phellberg76/Perfect-Vision-ECU/jlcpcb/production_files/BOM-Perfect-Vision-ECU.csv

Comment | Designator | Footprint | LCSC | Quantity
100R | R1 | R_0402_1005Metric | C25076 | 1
100k | R3 | R_0402_1005Metric | C25741 | 1
100nF | C1,C12,C2,C5,C6,C9 | C_0402_1005Metric | C1525 | 6
100uF 25v | C3 | CP_Elec_6.3x7.7 | C72477 | 1
100uH | L1 | L_12x12mm_H4.5mm | C504036 | 1
10R | R24 | R_0402_1005Metric | C25077 | 1
10k | R14,R15,R23 | R_0402_1005Metric | C25744 | 3
10k | R18,R19,R6 | R_0402_1005Metric | C2906861 | 3
10uF | C11 | C_0805_2012Metric | C15850 | 1
120R | R2 | R_0402_1005Metric | C25079 | 1
1N4148W | D10 | D_SOD-123 | C81598 | 1
1k | R5,R7,R8,R9 | R_0402_1005Metric | C11702 | 4
1uF | C17 | C_0402_1005Metric | C52923 | 1
200R | R20 | R_0603_1608Metric | C8218 | 1
220uF 25v | C4 | CP_Elec_8x10.5 | C3353 | 1
22pF | C7,C8 | C_0402_1005Metric | C1555 | 2
470k | R4 | R_0402_1005Metric | C25790 | 1
47nH | L2 | L_0402_1005Metric | C27151 | 1
5k1 | R34,R35 | R_0402_1005Metric | C22356228 | 2
8MHz | Y2 | Crystal_SMD_3225-4Pin_3.2x2.5mm | C2682774 | 1
BAT54J | D12 | D_SOD-323F | C358488 | 1
Conn_Coaxial | J6 | U.FL_Hirose_U.FL-R-SMT-1_Vertical | C88374 | 1
D_Schottky | D8 | D_SMC | C13763 | 1
D_Schottky | D1 | D_SMC | C18199210 | 1
D_TVS_Dual_ACA | D2,D3 | SOT-23 | C284078 | 2
ESP32-S3-MINI-1 | U2 | ESP32-S2-MINI-1 | C2913206 | 1
G6K-2 12V | K1 | Relay_DPDT_Omron_G6K-2F-Y | C397194 | 1
LED | D11,D7 | LED_0603_1608Metric | C2286 | 2
LM2596S-3.3 | U3 | TO-263-5_TabPin3 | C347420 | 1
MCP2515-xSO | U6 | SOIC-18W_7.5x11.6mm_P1.27mm | C153782 | 1
NEO-M9N-00B | U1 | SMT_9N-00B_UBL | C5119087 | 1
PRTR5V0U2X | D4 | SOT-143 | C5158049 | 1
PTVS18VZ1USK | D9 | D_SMA | C134965 | 1
PZT2222A | Q1 | SOT-223-3_TabPin2 | C115272 | 1
SN65HVD230 | U7,U8 | SOIC-8_3.9x4.9mm_P1.27mm | C12084 | 2
SS34 | D6 | D_SMA | C8678 | 1
USB_C_Receptacle_USB2.0_16P | J5 | USB_C_Receptacle_HRO_TYPE-C-31-M-12 | C165948 | 1
