phellberg76/Perfect-Vision-ECU/Perfect-Vision-ECU.kicad_pcb

## KiCad design Perfect-Vision-ECU.kicad_pcb (2026-10-21)

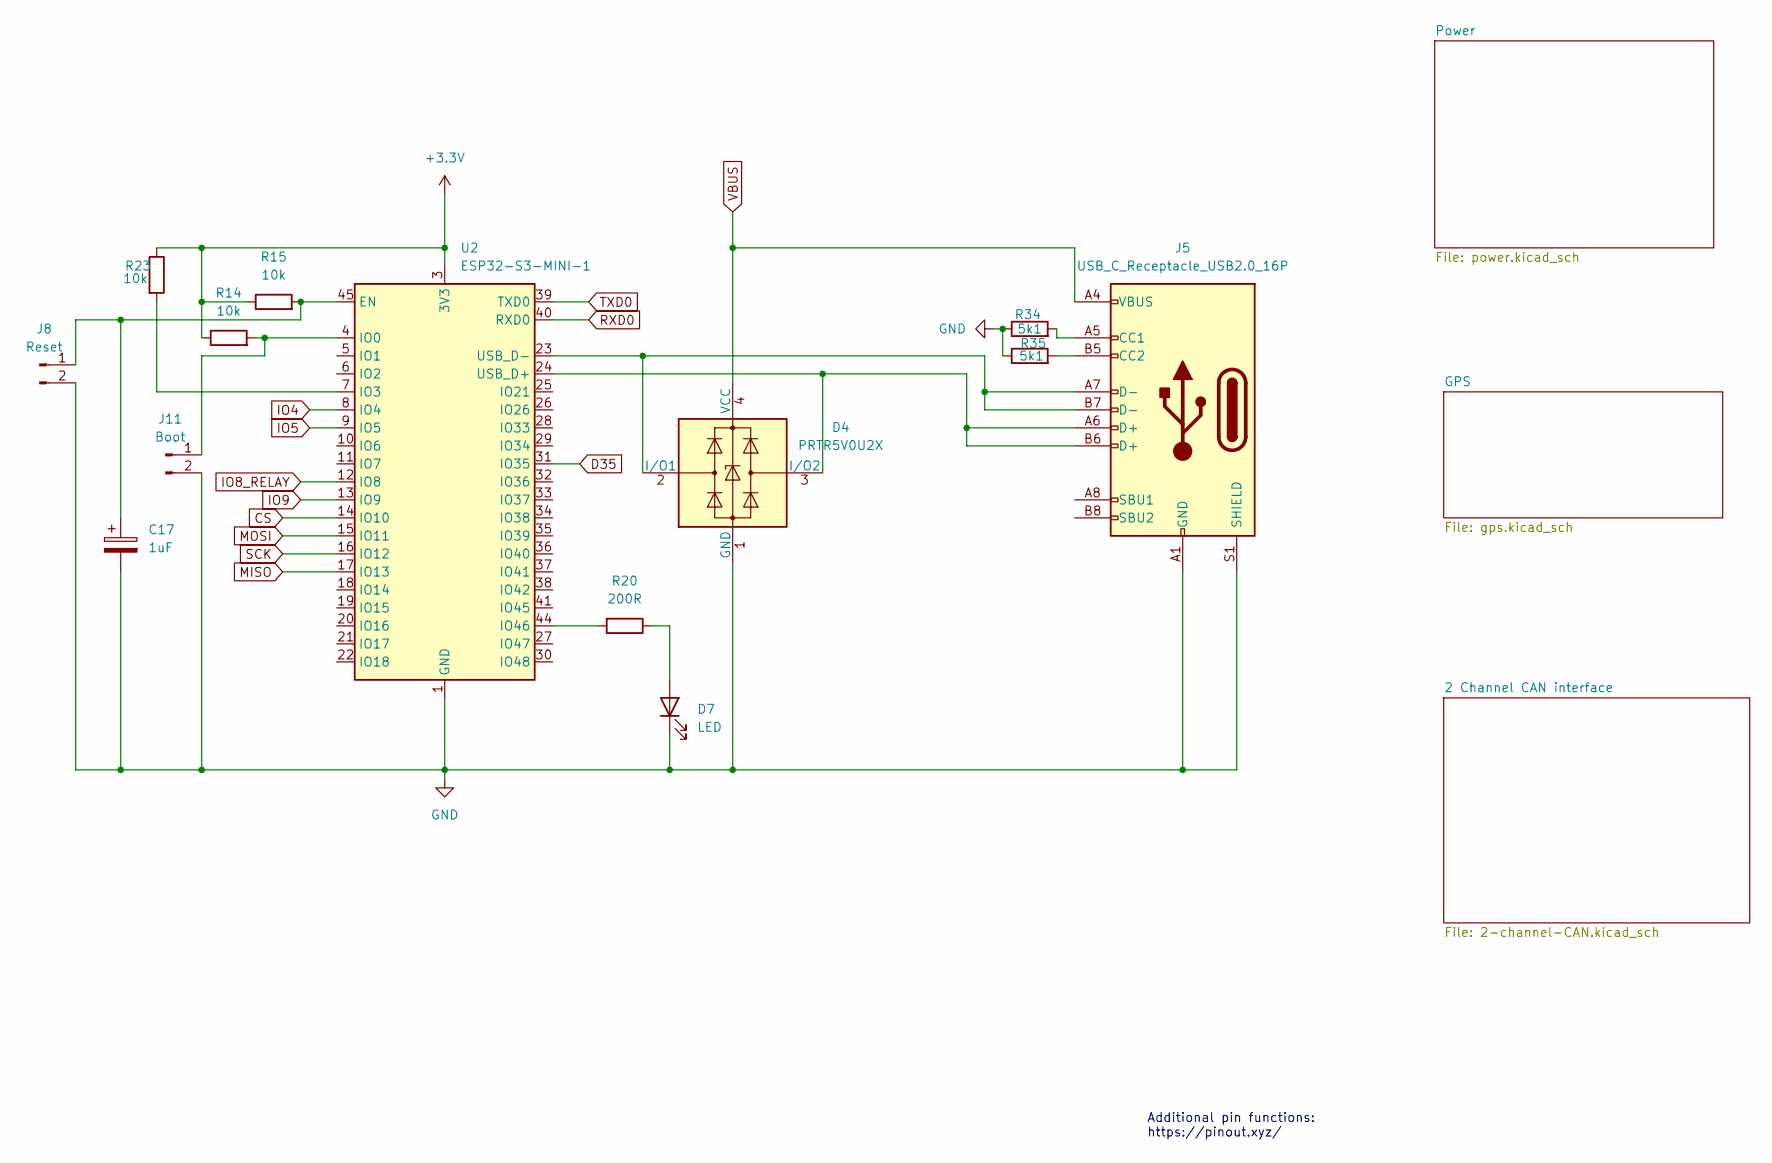
[picture p1: schematic Perfect-Vision-ECU.kicad_sch]

Parts:
C17: 1uF; C_0402_1005Metric
D4: PRTR5V0U2X; SOT-143
D7: LED; LED_0603_1608Metric
J5: USB_C_Receptacle_USB2.0_16P; USB_C_Receptacle_HRO_TYPE-C-31-M-12
J8: Reset; PinHeader_1x02_P2.54mm_Vertical
J11: Boot; PinHeader_1x02_P2.54mm_Vertical
R14, R15, R23: 10k; R_0402_1005Metric
R20: 200R; R_0603_1608Metric
R34, R35: 5k1; R_0402_1005Metric
U2: ESP32-S3-MINI-1; ESP32-S2-MINI-1

Connections:
+3.3V: R14.1, R15.1, R23.1, U2.3 (3V3); also elsewhere on the board
CS: U2.14 (IO10); also elsewhere on the board
D35: U2.31 (IO35); also elsewhere on the board
GND: C17.2, D4.1 (GND), D7.1 (K), J5.A1 (GND), J5.A12 (GND), J5.B1 (GND), J5.B12 (GND), J5.S1 (SHIELD), J8.2, J11.2, R34.1, R35.1, U2.1 (GND), U2.2 (GND), U2.42 (GND), U2.43 (GND), U2.46 (GND), U2.47 (GND), U2.48 (GND), U2.49 (GND), U2.50 (GND), U2.51 (GND), U2.52 (GND), U2.53 (GND), U2.54 (GND), U2.55 (GND), U2.56 (GND), U2.57 (GND), U2.58 (GND), U2.59 (GND), U2.60 (GND), U2.61 (GND), U2.62 (GND), U2.63 (GND), U2.64 (GND), U2.65 (GND); also elsewhere on the board
IO4: U2.8 (IO4); also elsewhere on the board
IO5: U2.9 (IO5); also elsewhere on the board
IO8_RELAY: U2.12 (IO8); also elsewhere on the board
IO9: U2.13 (IO9); also elsewhere on the board
MISO: U2.17 (IO13); also elsewhere on the board
MOSI: U2.15 (IO11); also elsewhere on the board
unnamed: D4.2 (I/O1), J5.A7 (D-), J5.B7 (D-), U2.23 (USB_D-)
unnamed: D4.3 (I/O2), J5.A6 (D+), J5.B6 (D+), U2.24 (USB_D+)
unnamed: D7.2 (A), R20.1
unnamed: J5.A5 (CC1), R34.2
unnamed: J5.B5 (CC2), R35.2
unnamed: C17.1, J8.1, R15.2, U2.45 (EN)
unnamed: J11.1, R14.2, U2.4 (IO0)
unnamed: R23.2, U2.7 (IO3)
unnamed: R20.2, U2.44 (IO46)
RXD0: U2.40 (RXD0); also elsewhere on the board
SCK: U2.16 (IO12); also elsewhere on the board
TXD0: U2.39 (TXD0); also elsewhere on the board
VBUS: D4.4 (VCC), J5.A4 (VBUS), J5.A9 (VBUS), J5.B4 (VBUS), J5.B9 (VBUS); also elsewhere on the board

Notes on the sheet:
Additional pin functions: https://pinout.xyz/

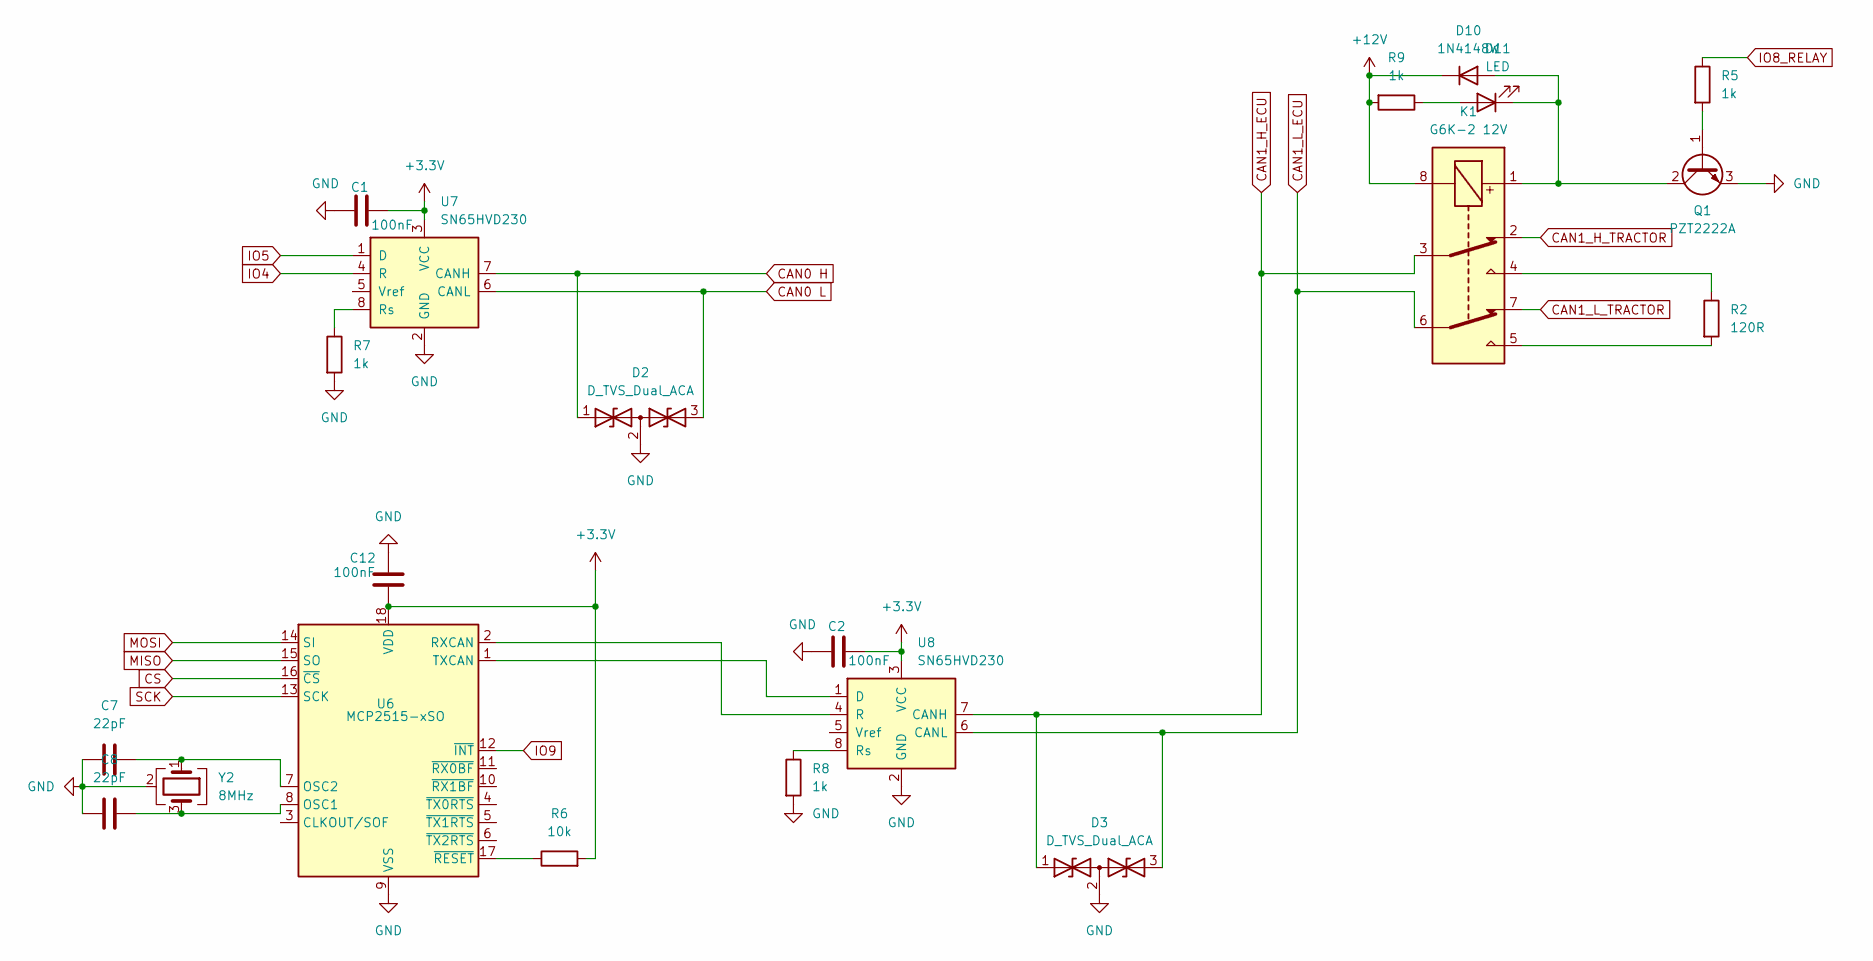
[picture p2: schematic 2-channel-CAN.kicad_sch]

Parts:
C1, C2, C12: 100nF; C_0402_1005Metric
C7, C8: 22pF; C_0402_1005Metric
D2, D3: D_TVS_Dual_ACA; SOT-23
D10: 1N4148W; D_SOD-123
D11: LED; LED_0603_1608Metric
K1: G6K-2 12V; Relay_DPDT_Omron_G6K-2F-Y
Q1: PZT2222A; SOT-223-3_TabPin2
R2: 120R; R_0402_1005Metric
R5, R7, R8, R9: 1k; R_0402_1005Metric
R6: 10k; R_0402_1005Metric
U6: MCP2515-xSO; SOIC-18W_7.5x11.6mm_P1.27mm
U7, U8: SN65HVD230; SOIC-8_3.9x4.9mm_P1.27mm
Y2: 8MHz; Crystal_SMD_3225-4Pin_3.2x2.5mm

Connections:
+3.3V: C1.1, C2.1, C12.2, R6.2, U6.18 (VDD), U7.3 (VCC), U8.3 (VCC); also elsewhere on the board
+12V: D10.1 (K), K1.8, R9.2; also elsewhere on the board
CAN0 H: D2.1 (A1), U7.7 (CANH); also elsewhere on the board
CAN0 L: D2.3 (A2), U7.6 (CANL); also elsewhere on the board
CAN1_H_ECU: D3.1 (A1), K1.3, U8.7 (CANH); also elsewhere on the board
CAN1_H_TRACTOR: K1.2; also elsewhere on the board
CAN1_L_ECU: D3.3 (A2), K1.6, U8.6 (CANL); also elsewhere on the board
CAN1_L_TRACTOR: K1.7; also elsewhere on the board
CS: U6.16 (~CS); also elsewhere on the board
GND: C1.2, C2.2, C7.1, C8.1, C12.1, D2.2 (common), D3.2 (common), Q1.3 (E), R7.2, R8.2, U6.9 (VSS), U7.2 (GND), U8.2 (GND), Y2.2 (G), Y2.4 (G); also elsewhere on the board
IO4: U7.4 (R); also elsewhere on the board
IO5: U7.1 (D); also elsewhere on the board
IO8_RELAY: R5.1; also elsewhere on the board
IO9: U6.12 (~INT); also elsewhere on the board
MISO: U6.15 (SO); also elsewhere on the board
MOSI: U6.14 (SI); also elsewhere on the board
unnamed: D10.2 (A), D11.1 (K), K1.1, Q1.2 (C)
unnamed: D11.2 (A), R9.1
unnamed: K1.4, R2.1
unnamed: K1.5, R2.2
unnamed: Q1.1 (B), R5.2
unnamed: C8.2, U6.8 (OSC1), Y2.3
unnamed: C7.2, U6.7 (OSC2), Y2.1
unnamed: U6.2 (RXCAN), U8.4 (R)
unnamed: U6.1 (TXCAN), U8.1 (D)
unnamed: R6.1, U6.17 (~RESET)
unnamed: R7.1, U7.8 (Rs)
unnamed: R8.1, U8.8 (Rs)
SCK: U6.13 (SCK); also elsewhere on the board

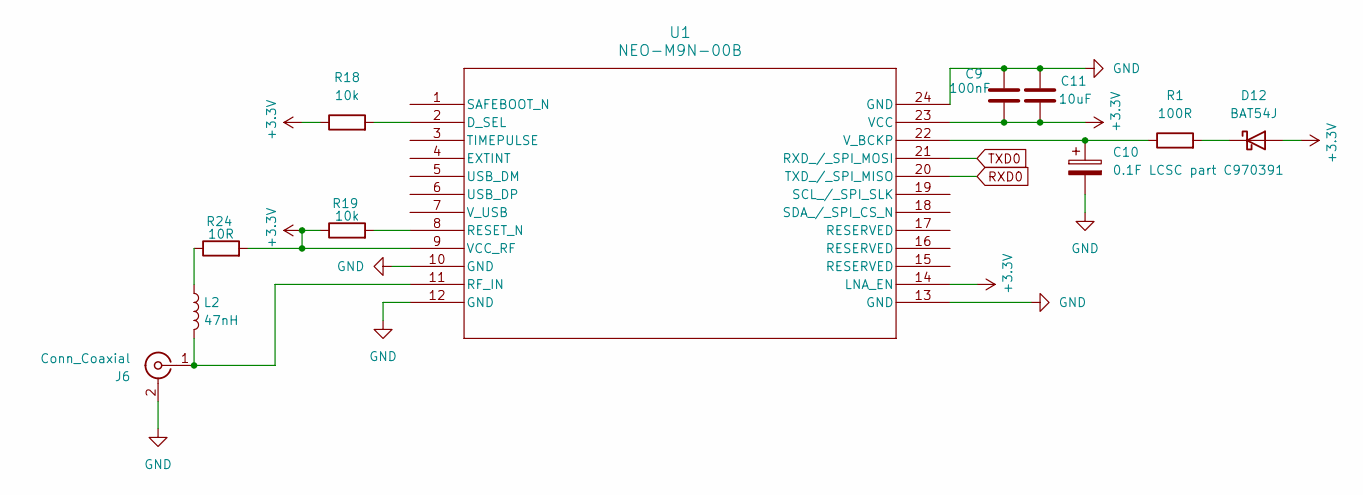
[picture p3: schematic gps.kicad_sch]

Parts:
C9: 100nF; C_0402_1005Metric
C10: 0.1F LCSC part C970391; CP_Radial_D8.0mm_P3.50mm
C11: 10uF; C_0805_2012Metric
D12: BAT54J; D_SOD-323F
J6: Conn_Coaxial; U.FL_Hirose_U.FL-R-SMT-1_Vertical
L2: 47nH; L_0402_1005Metric
R1: 100R; R_0402_1005Metric
R18, R19: 10k; R_0402_1005Metric
R24: 10R; R_0402_1005Metric
U1: NEO-M9N-00B; SMT_9N-00B_UBL

Connections:
+3.3V: C9.2, C11.2, D12.2 (A), R18.1, R19.1, R24.2, U1.9 (VCC_RF), U1.14 (LNA_EN), U1.23 (VCC); also elsewhere on the board
GND: C9.1, C10.2, C11.1, J6.2 (Ext), U1.10 (GND), U1.12 (GND), U1.13 (GND), U1.24 (GND); also elsewhere on the board
unnamed: D12.1 (K), R1.2
unnamed: J6.1 (In), L2.2, U1.11 (RF_IN)
unnamed: L2.1, R24.1
unnamed: R18.2, U1.2 (D_SEL)
unnamed: R19.2, U1.8 (RESET_N)
unnamed: C10.1, R1.1, U1.22 (V_BCKP)
RXD0: U1.20 (TXD_/_SPI_MISO); also elsewhere on the board
TXD0: U1.21 (RXD_/_SPI_MOSI); also elsewhere on the board

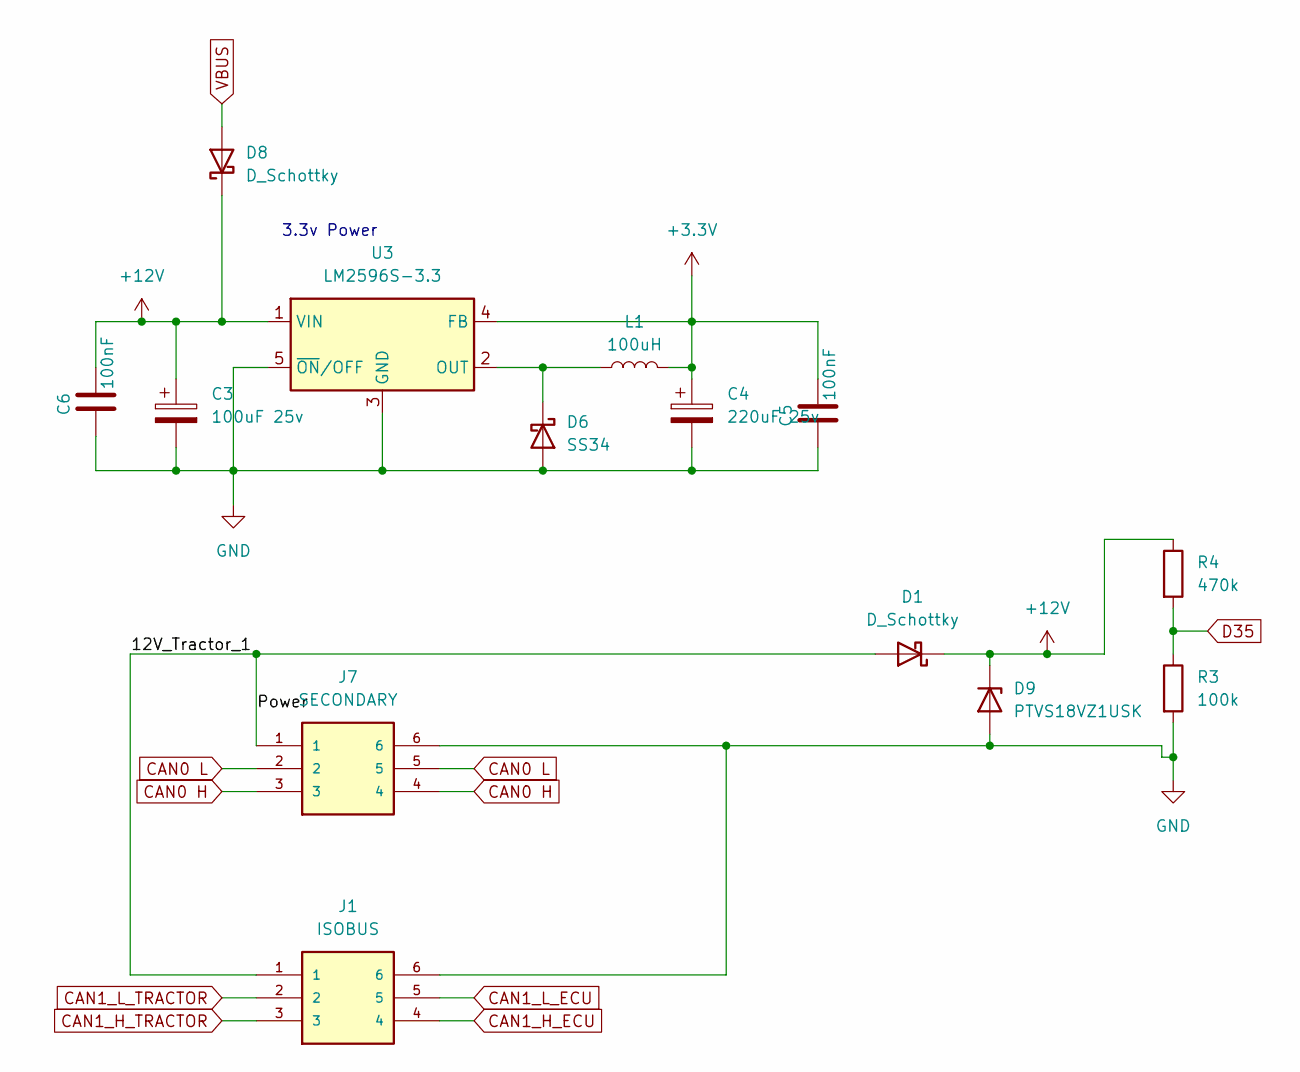
[picture p4: schematic power.kicad_sch]

Parts:
C3: 100uF 25v; CP_Elec_6.3x7.7
C4: 220uF 25v; CP_Elec_8x10.5
C5, C6: 100nF; C_0402_1005Metric
D1, D8: D_Schottky; D_SMC
D6: SS34; D_SMA
D9: PTVS18VZ1USK; D_SMA
J1: ISOBUS; AT04-6P-BM; PARTREV C1
J7: SECONDARY; AT04-6P-BM; PARTREV C1
L1: 100uH; L_12x12mm_H4.5mm
R3: 100k; R_0402_1005Metric
R4: 470k; R_0402_1005Metric
U3: LM2596S-3.3; TO-263-5_TabPin3

Connections:
+3.3V: C4.1, C5.1, L1.2, U3.4 (FB); also elsewhere on the board
+12V: C3.1, C6.1, D1.1 (K), D8.1 (K), D9.1 (K), R4.1, U3.1 (VIN); also elsewhere on the board
/Power/12V_Tractor_1: D1.2 (A), J1.1, J7.1
CAN0 H: J7.3, J7.4; also elsewhere on the board
CAN0 L: J7.2, J7.5; also elsewhere on the board
CAN1_H_ECU: J1.4; also elsewhere on the board
CAN1_H_TRACTOR: J1.3; also elsewhere on the board
CAN1_L_ECU: J1.5; also elsewhere on the board
CAN1_L_TRACTOR: J1.2; also elsewhere on the board
D35: R3.1, R4.2; also elsewhere on the board
GND: C3.2, C4.2, C5.2, C6.2, D6.2 (A), D9.2 (A), J1.6, J7.6, R3.2, U3.3 (GND), U3.5 (~ON/OFF); also elsewhere on the board
unnamed: D6.1 (K), L1.1, U3.2 (OUT)
VBUS: D8.2 (A); also elsewhere on the board

Notes on the sheet:
3.3v Power

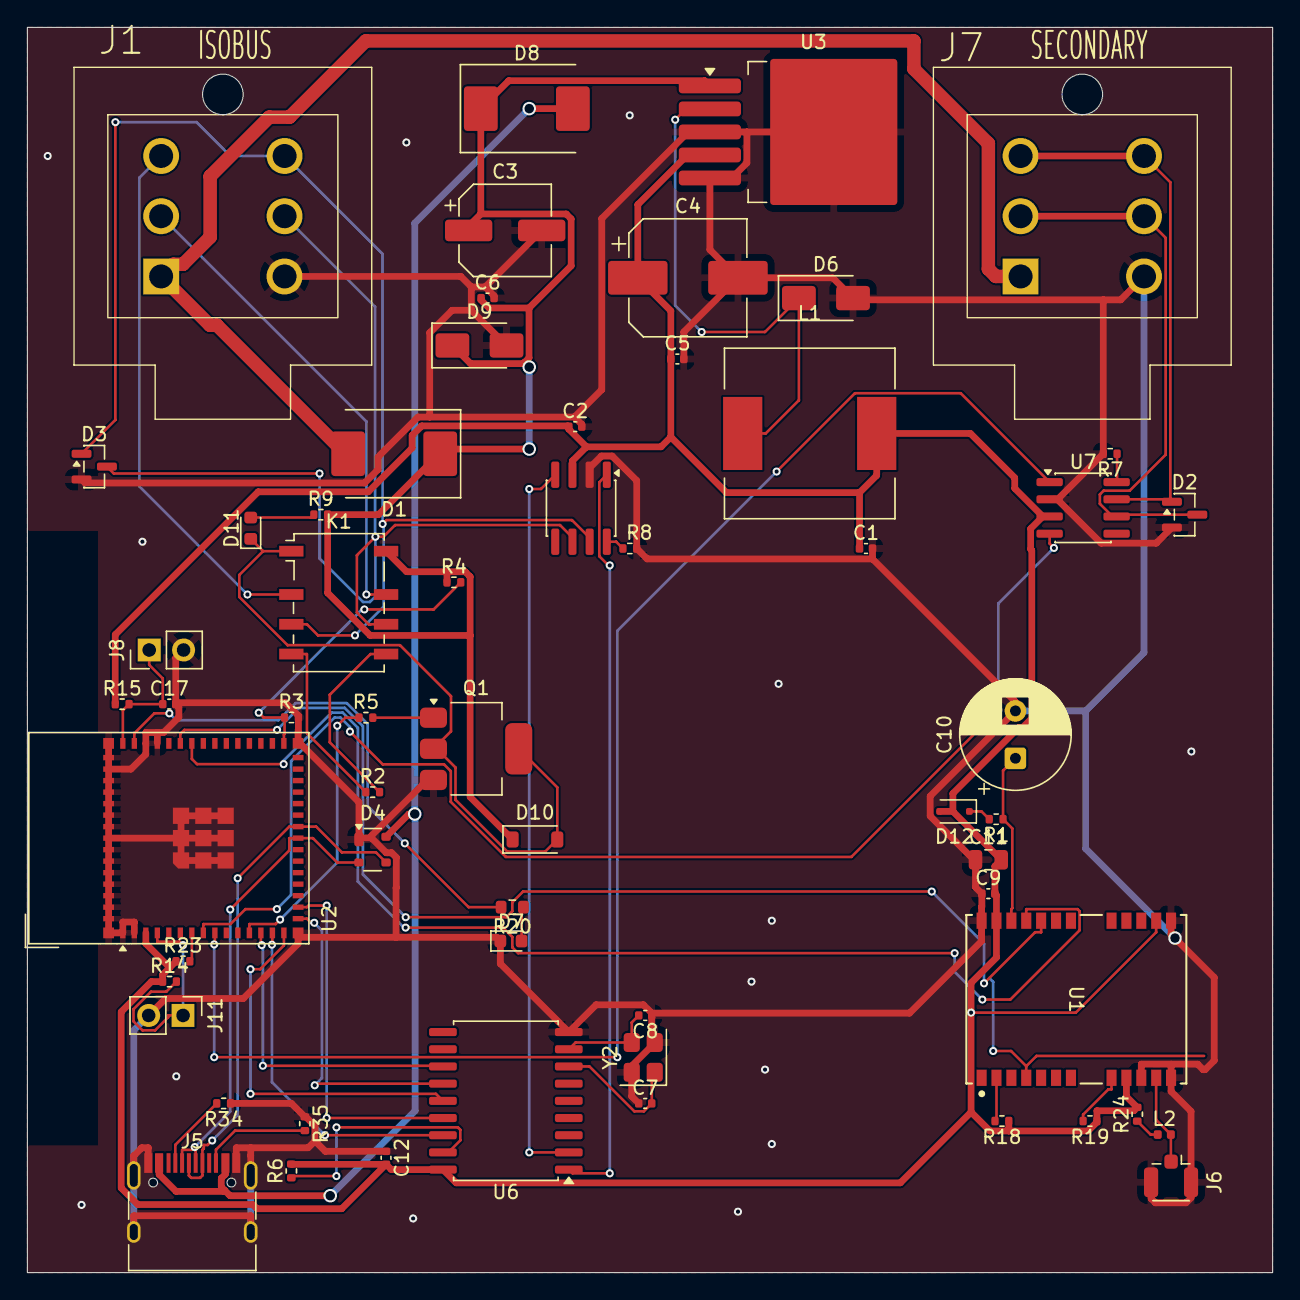
[picture p5: board Perfect-Vision-ECU.kicad_pcb from above]

Board: 2 copper layers, 92.0 x 92.0 mm, 59 parts (0 on the bottom side), 50 nets.
