phellberg76/Perfect-Vision-ECU/firmware/main/main.c

/**
 * @file main.c
 * @brief Perfect Vision ECU - CAN/BLE Bridge Main Application
 *
 * This firmware provides a CAN-to-BLE bridge functionality for the
 * Perfect Vision ECU. It reads CAN messages from two channels:
 * - CAN0: ESP32-S3 internal TWAI controller
 * - CAN1: MCP2515 external SPI CAN controller
 *
 * Messages are buffered and streamed via BLE (Nordic UART Service) to
 * a connected Flutter app. OTA firmware updates are supported via WiFi,
 * triggered by BLE commands from the app.
 *
 * GPS Integration Status
 * ----------------------
 * Basic GPS reading and NMEA parsing is implemented (gps.c):
 * - UART reading from GPS module (TXD0/RXD0 - see gps.kicad_sch)
 * - GGA parsing for position, fix quality, satellites
 * - RMC parsing for speed and course
 * - Raw NMEA logging enabled for testing
 *
 * TODO: Remaining GPS tasks:
 * - Add GPS data to BLE stream alongside CAN messages
 * - Add BLE command to enable/disable GPS streaming
 * - Use GPS as fallback when ISOBUS position data is unavailable
 */

#include <stdio.h>
#include <string.h>

#include "freertos/FreeRTOS.h"
#include "freertos/task.h"
#include "esp_system.h"
#include "esp_log.h"
#include "esp_ota_ops.h"
#include "nvs_flash.h"
#include "cJSON.h"

#include "driver/gpio.h"
#include "driver/uart.h"

#include "config.h"
#include "pin_config.h"
#include "can_manager.h"
#include "can_buffer.h"
#include "ble_nus.h"
#include "wifi_ota.h"
#include "gps.h"
#include "status_led.h"
#include "web_log.h"
#include "wifi_transfer.h"

static const char *TAG = "main";

// Cached firmware hash (SHA256)
static char s_firmware_hash[65] = {0};

// Current request ID (for including in responses)
static int s_current_request_id = -1;

// WiFi scan request ID (saved because scan is async)
static int s_wifi_scan_request_id = -1;

// Binary CAN TX mode
static bool s_can_tx_binary_mode = false;
static uint32_t s_can_tx_frame_count = 0;

// Forward declarations
static void on_ble_receive(const char *data, size_t len);
static void on_ble_binary_receive(const uint8_t *data, size_t len);
static void on_ble_connection_change(bool connected);
static void on_wifi_ota_progress(wifi_ota_status_t status, int progress,
                                  size_t received, size_t total, const char *message);
static void on_wifi_scan_result(const wifi_scan_result_t *results, size_t count,
                                 const char *error_msg);
static void on_wifi_transfer_state_change(wifi_transfer_state_t state);
static void on_wifi_transfer_receive(const uint8_t *data, size_t len);

// -----------------------------------------------------------------------------
// Response Helpers
// -----------------------------------------------------------------------------

static void send_json_response(cJSON *json)
{
    // Include request ID in response if available
    if (s_current_request_id >= 0) {
        cJSON_AddNumberToObject(json, "id", s_current_request_id);
    }

    char *str = cJSON_PrintUnformatted(json);
    if (str) {
        ble_nus_send(str, 0);
        free(str);
    }
    cJSON_Delete(json);
}

static void send_error(int code, const char *message)
{
    cJSON *json = cJSON_CreateObject();
    cJSON_AddStringToObject(json, "type", "error");
    cJSON_AddNumberToObject(json, "code", code);
    cJSON_AddStringToObject(json, "message", message);
    send_json_response(json);
}

static void send_ok(const char *message)
{
    cJSON *json = cJSON_CreateObject();
    cJSON_AddStringToObject(json, "type", "ok");
    if (message) {
        cJSON_AddStringToObject(json, "message", message);
    }
    send_json_response(json);
}

static void send_debug(const char *message)
{
    cJSON *json = cJSON_CreateObject();
    cJSON_AddStringToObject(json, "type", "debug");
    cJSON_AddStringToObject(json, "message", message);
    send_json_response(json);
}

// -----------------------------------------------------------------------------
// Firmware Hash
// -----------------------------------------------------------------------------

static const char* get_firmware_hash(void)
{
    if (s_firmware_hash[0] != '\0') {
        return s_firmware_hash;
    }

    const esp_partition_t *running = esp_ota_get_running_partition();
    if (running == NULL) {
        return "unknown";
    }

    esp_app_desc_t app_desc;
    if (esp_ota_get_partition_description(running, &app_desc) != ESP_OK) {
        return "unknown";
    }

    // Convert SHA256 to hex string
    for (int i = 0; i < 32; i++) {
        snprintf(&s_firmware_hash[i * 2], 3, "%02x", app_desc.app_elf_sha256[i]);
    }
    s_firmware_hash[64] = '\0';

    return s_firmware_hash;
}

// -----------------------------------------------------------------------------
// BLE Command Handlers
// -----------------------------------------------------------------------------

static void handle_version_cmd(void)
{
    cJSON *json = cJSON_CreateObject();
    cJSON_AddStringToObject(json, "type", "version");
    cJSON_AddStringToObject(json, "version", FIRMWARE_VERSION);
    cJSON_AddStringToObject(json, "model", DEVICE_MODEL);
    cJSON_AddStringToObject(json, "hash", get_firmware_hash());
    send_json_response(json);
}

static void handle_status_cmd(void)
{
    uint32_t can0_rx, can0_err, can1_rx, can1_err;
    uint32_t overflow, total;

    can_manager_get_stats(CAN_CHANNEL_0, &can0_rx, &can0_err);
    can_manager_get_stats(CAN_CHANNEL_1, &can1_rx, &can1_err);
    can_buffer_get_stats(&overflow, &total);

    cJSON *json = cJSON_CreateObject();
    cJSON_AddStringToObject(json, "type", "status");
    cJSON_AddBoolToObject(json, "can_running", can_manager_is_running());
    cJSON_AddNumberToObject(json, "can0_rx", can0_rx);
    cJSON_AddNumberToObject(json, "can0_err", can0_err);
    cJSON_AddNumberToObject(json, "can1_rx", can1_rx);
    cJSON_AddNumberToObject(json, "can1_err", can1_err);
    cJSON_AddNumberToObject(json, "buffer_count", can_buffer_count());
    cJSON_AddNumberToObject(json, "buffer_overflow", overflow);
    cJSON_AddNumberToObject(json, "total_messages", total);
    send_json_response(json);
}

static void handle_can_start_cmd(void)
{
    if (can_manager_is_running()) {
        send_ok("CAN already running");
        return;
    }

    esp_err_t err = can_manager_start();
    if (err == ESP_OK) {
        send_ok("CAN started");
    } else {
        send_error(40, "Failed to start CAN");
    }
}

static void handle_can_stop_cmd(void)
{
    can_manager_stop();
    send_ok("CAN stopped");
}

static void handle_clear_buffer_cmd(void)
{
    can_buffer_clear();
    send_ok("Buffer cleared");
}

static void handle_clear_stats_cmd(void)
{
    can_manager_reset_stats();
    can_buffer_reset_stats();
    send_ok("Statistics cleared");
}

/**
 * @brief Handle CAN send command
 *
 * JSON format:
 * {
 *   "cmd": "can_send",
 *   "ch": 1,                    // Channel: 0 or 1
 *   "id": 418119462,            // CAN ID (decimal)
 *   "ext": true,                // Extended ID (optional, default true)
 *   "dlc": 8,                   // Data length 0-8
 *   "data": [1,2,3,4,5,6,7,8]   // Data bytes array
 * }
 */
static void handle_can_send_cmd(cJSON *json)
{
    // Parse channel
    cJSON *ch_item = cJSON_GetObjectItem(json, "ch");
    if (!cJSON_IsNumber(ch_item)) {
        send_error(70, "Missing 'ch' (channel)");
        return;
    }
    int channel = (int)ch_item->valuedouble;
    if (channel < 0 || channel > 1) {
        send_error(71, "Invalid channel (must be 0 or 1)");
        return;
    }

    // Parse CAN ID
    cJSON *id_item = cJSON_GetObjectItem(json, "id");
    if (!cJSON_IsNumber(id_item)) {
        send_error(72, "Missing 'id' (CAN ID)");
        return;
    }
    uint32_t can_id = (uint32_t)id_item->valuedouble;

    // Parse extended ID flag (default true for ISOBUS)
    bool extended = true;
    cJSON *ext_item = cJSON_GetObjectItem(json, "ext");
    if (cJSON_IsBool(ext_item)) {
        extended = cJSON_IsTrue(ext_item);
    }

    // Parse DLC
    cJSON *dlc_item = cJSON_GetObjectItem(json, "dlc");
    if (!cJSON_IsNumber(dlc_item)) {
        send_error(73, "Missing 'dlc'");
        return;
    }
    int dlc = (int)dlc_item->valuedouble;
    if (dlc < 0 || dlc > 8) {
        send_error(74, "Invalid DLC (must be 0-8)");
        return;
    }

    // Parse data array
    cJSON *data_item = cJSON_GetObjectItem(json, "data");
    if (!cJSON_IsArray(data_item)) {
        send_error(75, "Missing 'data' array");
        return;
    }

    uint8_t data[8] = {0};
    int data_len = cJSON_GetArraySize(data_item);
    if (data_len > 8) data_len = 8;

    for (int i = 0; i < data_len; i++) {
        cJSON *byte_item = cJSON_GetArrayItem(data_item, i);
        if (cJSON_IsNumber(byte_item)) {
            data[i] = (uint8_t)byte_item->valuedouble;
        }
    }

    // Send the CAN frame
    esp_err_t err = can_manager_send((can_channel_t)channel, can_id, data, (uint8_t)dlc, extended);
    if (err == ESP_OK) {
        ESP_LOGI(TAG, "CAN TX: ch=%d id=0x%08lX dlc=%d", channel, (unsigned long)can_id, dlc);
        send_ok("CAN frame sent");
    } else {
        ESP_LOGE(TAG, "CAN TX failed: %s", esp_err_to_name(err));
        send_error(76, "CAN send failed");
    }
}

/**
 * @brief Handle binary CAN TX data
 *
 * Parses 19-byte CAN frames and sends them on the bus.
 * Frame format (same as RX stream):
 *   [0]      channel (0 or 1)
 *   [1-4]    timestamp (ignored for TX, can be used as sequence)
 *   [5-8]    CAN ID (little-endian)
 *   [9]      flags: bit0=extended, bit1=RTR
 *   [10]     DLC (0-8)
 *   [11-18]  data bytes
 */
static void on_ble_binary_receive(const uint8_t *data, size_t len)
{
    // Process complete 19-byte frames
    size_t offset = 0;
    while (offset + 19 <= len) {
        const uint8_t *frame = data + offset;

        uint8_t channel = frame[0];
        // timestamp at frame[1-4] - ignored for TX
        uint32_t can_id = frame[5] | (frame[6] << 8) | (frame[7] << 16) | (frame[8] << 24);
        uint8_t flags = frame[9];
        uint8_t dlc = frame[10];
        const uint8_t *frame_data = &frame[11];

        bool extended = (flags & 0x01) != 0;
        // RTR flag at bit 1 - not typically used for TX

        // Validate
        if (channel > 1 || dlc > 8) {
            ESP_LOGW(TAG, "Invalid binary frame: ch=%d dlc=%d", channel, dlc);
            offset += 19;
            continue;
        }

        // Send the CAN frame
        esp_err_t err = can_manager_send((can_channel_t)channel, can_id, frame_data, dlc, extended);
        if (err == ESP_OK) {
            s_can_tx_frame_count++;
        } else {
            ESP_LOGD(TAG, "Binary CAN TX failed: %s", esp_err_to_name(err));
        }

        offset += 19;
    }

    // Log any trailing bytes
    if (offset < len) {
        ESP_LOGD(TAG, "Binary RX: %zu trailing bytes (incomplete frame)", len - offset);
    }
}

/**
 * @brief Handle CAN TX mode command
 *
 * JSON format:
 * {"cmd":"can_tx_mode","enabled":true}   - Enable binary TX mode
 * {"cmd":"can_tx_mode","enabled":false}  - Disable binary TX mode
 * {"cmd":"can_tx_mode"}                  - Query current mode
 */
static void handle_can_tx_mode_cmd(cJSON *json)
{
    cJSON *enabled_item = cJSON_GetObjectItem(json, "enabled");

    if (cJSON_IsBool(enabled_item)) {
        bool enable = cJSON_IsTrue(enabled_item);

        if (enable && !s_can_tx_binary_mode) {
            // Send response FIRST before changing mode (mode change may affect BLE TX)
            send_ok("Binary TX mode enabled");

            // Wait for BLE stack to transmit response before changing mode
            vTaskDelay(pdMS_TO_TICKS(100));

            // Then enable binary TX mode
            ble_nus_set_binary_mode(true, on_ble_binary_receive);
            s_can_tx_binary_mode = true;
            s_can_tx_frame_count = 0;
            ESP_LOGI(TAG, "Binary CAN TX mode enabled");
        } else if (!enable && s_can_tx_binary_mode) {
            // Disable binary TX mode first
            ble_nus_set_binary_mode(false, NULL);
            s_can_tx_binary_mode = false;
            ESP_LOGI(TAG, "Binary CAN TX mode disabled (sent %lu frames)",
                     (unsigned long)s_can_tx_frame_count);
            send_ok("Binary TX mode disabled");
        } else {
            send_ok(s_can_tx_binary_mode ? "Already in binary mode" : "Already in JSON mode");
        }
    } else {
        // Query mode - return current state
        cJSON *resp = cJSON_CreateObject();
        cJSON_AddStringToObject(resp, "type", "status");
        cJSON_AddBoolToObject(resp, "binary_tx_mode", s_can_tx_binary_mode);
        cJSON_AddNumberToObject(resp, "tx_frame_count", s_can_tx_frame_count);
        send_json_response(resp);
    }
}

static void handle_wifi_scan_cmd(void)
{
    if (wifi_ota_is_active()) {
        send_error(50, "OTA in progress");
        return;
    }

    if (wifi_scan_is_active()) {
        send_error(51, "Scan already in progress");
        return;
    }

    // Save the request ID for the async callback
    s_wifi_scan_request_id = s_current_request_id;

    esp_err_t err = wifi_scan_start(on_wifi_scan_result);
    if (err != ESP_OK) {
        s_wifi_scan_request_id = -1;
        send_error(52, "Failed to start WiFi scan");
    }
    // Results sent via callback
}

static void handle_wifi_ota_cmd(cJSON *json)
{
    if (wifi_ota_is_active()) {
        send_error(60, "OTA already in progress");
        return;
    }

    cJSON *ssid_item = cJSON_GetObjectItem(json, "ssid");
    cJSON *password_item = cJSON_GetObjectItem(json, "password");
    cJSON *url_item = cJSON_GetObjectItem(json, "url");
    cJSON *token_item = cJSON_GetObjectItem(json, "token");
    cJSON *size_item = cJSON_GetObjectItem(json, "size");
    cJSON *hash_item = cJSON_GetObjectItem(json, "hash");

    if (!cJSON_IsString(ssid_item) || !cJSON_IsString(url_item)) {
        send_error(61, "Missing ssid or url");
        return;
    }

    wifi_ota_config_t config = {
        .ssid = ssid_item->valuestring,
        .password = cJSON_IsString(password_item) ? password_item->valuestring : NULL,
        .url = url_item->valuestring,
        .auth_token = cJSON_IsString(token_item) ? token_item->valuestring : NULL,
        .expected_size = cJSON_IsNumber(size_item) ? (size_t)size_item->valuedouble : 0,
        .expected_hash = cJSON_IsString(hash_item) ? hash_item->valuestring : NULL,
    };

    esp_err_t err = wifi_ota_start(&config, on_wifi_ota_progress);
    if (err != ESP_OK) {
        send_error(62, "Failed to start OTA");
    }
    // Progress sent via callback
}

static void handle_wifi_ota_abort_cmd(void)
{
    if (!wifi_ota_is_active()) {
        send_error(63, "No OTA in progress");
        return;
    }

    wifi_ota_abort();
    send_ok("OTA abort requested");
}

/**
 * @brief Handle local WiFi OTA command (for relay via tablet hotspot)
 *
 * JSON format:
 * {
 *   "cmd": "wifi_ota_local",
 *   "url": "http://192.168.43.1:8766/firmware.bin"
 * }
 */
static void handle_wifi_ota_local_cmd(cJSON *json)
{
    if (wifi_ota_is_active()) {
        send_error(64, "OTA already in progress");
        return;
    }

    // Check that we're connected to WiFi via wifi_transfer
    if (wifi_transfer_get_state() != WIFI_TRANSFER_READY &&
        wifi_transfer_get_state() != WIFI_TRANSFER_CONNECTED) {
        send_error(65, "Not connected to hotspot - use wifi_connect first");
        return;
    }

    cJSON *url_item = cJSON_GetObjectItem(json, "url");
    if (!cJSON_IsString(url_item) || strlen(url_item->valuestring) == 0) {
        send_error(66, "Missing 'url'");
        return;
    }

    ESP_LOGI(TAG, "Local WiFi OTA: url=%s", url_item->valuestring);

    esp_err_t err = wifi_ota_start_local(url_item->valuestring, on_wifi_ota_progress);
    if (err != ESP_OK) {
        send_error(67, "Failed to start local OTA");
    }
    // Progress sent via callback
}

static void handle_reboot_cmd(void)
{
    ESP_LOGI(TAG, "Reboot requested via BLE");
    send_ok("Rebooting...");

    // Give time for the response to be sent
    vTaskDelay(pdMS_TO_TICKS(500));

    esp_restart();
}

/**
 * @brief Handle web log command
 *
 * JSON format:
 * {"cmd":"web_log","enabled":true}   - Start web log server
 * {"cmd":"web_log","enabled":false}  - Stop web log server
 * {"cmd":"web_log"}                  - Query status
 *
 * When enabled, connects to WiFi AP:
 *   SSID: PV_LOG_XXXXXX (where X is part of MAC)
 *   Password: pvdebug123
 *   URL: http://192.168.4.1/
 */
static void handle_web_log_cmd(cJSON *json)
{
    cJSON *enabled_item = cJSON_GetObjectItem(json, "enabled");

    if (cJSON_IsBool(enabled_item)) {
        bool enable = cJSON_IsTrue(enabled_item);

        if (enable && !web_log_is_running()) {
            esp_err_t err = web_log_start();
            if (err == ESP_OK) {
                cJSON *resp = cJSON_CreateObject();
                cJSON_AddStringToObject(resp, "type", "ok");
                cJSON_AddStringToObject(resp, "message", "Web log started");
                cJSON_AddStringToObject(resp, "ssid", web_log_get_ssid());
                cJSON_AddStringToObject(resp, "password", "pvdebug123");
                cJSON_AddStringToObject(resp, "url", "http://192.168.4.1/");
                send_json_response(resp);
            } else {
                send_error(80, "Failed to start web log");
            }
        } else if (!enable && web_log_is_running()) {
            web_log_stop();
            send_ok("Web log stopped");
        } else {
            send_ok(web_log_is_running() ? "Already running" : "Already stopped");
        }
    } else {
        // Query status
        cJSON *resp = cJSON_CreateObject();
        cJSON_AddStringToObject(resp, "type", "status");
        cJSON_AddBoolToObject(resp, "web_log_running", web_log_is_running());
        if (web_log_is_running()) {
            cJSON_AddStringToObject(resp, "ssid", web_log_get_ssid());
            cJSON_AddStringToObject(resp, "url", "http://192.168.4.1/");
        }
        send_json_response(resp);
    }
}

/**
 * @brief Handle WiFi transfer connect command
 *
 * JSON format:
 * {
 *   "cmd": "wifi_connect",
 *   "ssid": "hotspot_ssid",
 *   "pass": "hotspot_password",
 *   "ip": "192.168.43.1",
 *   "port": 8765
 * }
 */
static void handle_wifi_connect_cmd(cJSON *json)
{
    // Check if web_log is using WiFi
    if (web_log_is_running()) {
        send_error(90, "Web log is using WiFi, stop it first");
        return;
    }

    // Check if OTA is using WiFi
    if (wifi_ota_is_active()) {
        send_error(91, "OTA is using WiFi");
        return;
    }

    // Parse SSID
    cJSON *ssid_item = cJSON_GetObjectItem(json, "ssid");
    if (!cJSON_IsString(ssid_item) || strlen(ssid_item->valuestring) == 0) {
        send_error(92, "Missing 'ssid'");
        return;
    }

    // Parse password
    cJSON *pass_item = cJSON_GetObjectItem(json, "pass");
    if (!cJSON_IsString(pass_item)) {
        send_error(93, "Missing 'pass'");
        return;
    }

    // Parse host IP
    cJSON *ip_item = cJSON_GetObjectItem(json, "ip");
    if (!cJSON_IsString(ip_item) || strlen(ip_item->valuestring) == 0) {
        send_error(94, "Missing 'ip'");
        return;
    }

    // Parse port
    cJSON *port_item = cJSON_GetObjectItem(json, "port");
    if (!cJSON_IsNumber(port_item)) {
        send_error(95, "Missing 'port'");
        return;
    }
    uint16_t port = (uint16_t)port_item->valuedouble;

    // Parse BSSID (optional - for targeting specific AP)
    cJSON *bssid_item = cJSON_GetObjectItem(json, "bssid");
    const char *bssid = NULL;
    if (cJSON_IsString(bssid_item) && strlen(bssid_item->valuestring) > 0) {
        bssid = bssid_item->valuestring;
    }

    ESP_LOGI(TAG, "WiFi connect: ssid=%s ip=%s port=%d bssid=%s",
             ssid_item->valuestring, ip_item->valuestring, port, bssid ? bssid : "any");

    // Start connection (async - state callback will notify when ready)
    esp_err_t err = wifi_transfer_connect(
        ssid_item->valuestring,
        pass_item->valuestring,
        ip_item->valuestring,
        port,
        bssid);

    if (err == ESP_OK) {
        send_ok("WiFi transfer connected");
    } else {
        char msg[64];
        snprintf(msg, sizeof(msg), "WiFi connect failed: %s", esp_err_to_name(err));
        send_error(96, msg);
    }
}

/**
 * @brief Handle WiFi transfer disconnect command
 */
static void handle_wifi_disconnect_cmd(void)
{
    if (!wifi_transfer_is_ready() && wifi_transfer_get_state() == WIFI_TRANSFER_DISCONNECTED) {
        send_ok("Already disconnected");
        return;
    }

    esp_err_t err = wifi_transfer_disconnect();
    if (err == ESP_OK) {
        send_ok("WiFi transfer disconnected");
    } else {
        send_error(97, "WiFi disconnect failed");
    }
}

/**
 * @brief Handle WiFi transfer status command
 */
static void handle_wifi_status_cmd(void)
{
    cJSON *resp = cJSON_CreateObject();
    cJSON_AddStringToObject(resp, "type", "wifi_status");

    wifi_transfer_state_t state = wifi_transfer_get_state();
    const char *state_str;
    switch (state) {
        case WIFI_TRANSFER_DISCONNECTED: state_str = "disconnected"; break;
        case WIFI_TRANSFER_CONNECTING:   state_str = "connecting"; break;
        case WIFI_TRANSFER_CONNECTED:    state_str = "connected"; break;
        case WIFI_TRANSFER_READY:        state_str = "ready"; break;
        case WIFI_TRANSFER_ERROR:        state_str = "error"; break;
        default:                         state_str = "unknown"; break;
    }
    cJSON_AddStringToObject(resp, "state", state_str);
    cJSON_AddBoolToObject(resp, "ready", wifi_transfer_is_ready());

    uint32_t tx_bytes, rx_bytes, tx_frames;
    wifi_transfer_get_stats(&tx_bytes, &rx_bytes, &tx_frames);
    cJSON_AddNumberToObject(resp, "tx_bytes", tx_bytes);
    cJSON_AddNumberToObject(resp, "rx_bytes", rx_bytes);
    cJSON_AddNumberToObject(resp, "tx_frames", tx_frames);

    send_json_response(resp);
}

// -----------------------------------------------------------------------------
// WiFi Transfer Callbacks
// -----------------------------------------------------------------------------

static void on_wifi_transfer_state_change(wifi_transfer_state_t state)
{
    // Update LED state based on WiFi transfer status
    if (state == WIFI_TRANSFER_READY) {
        status_led_set_state(STATUS_LED_BLINK_2HZ);  // Fast blink = high-speed mode
        ESP_LOGI(TAG, "WiFi transfer ready - CAN data will stream over WiFi");
    } else if (state == WIFI_TRANSFER_DISCONNECTED || state == WIFI_TRANSFER_ERROR) {
        if (ble_nus_is_connected()) {
            status_led_set_state(STATUS_LED_BLINK_1HZ);  // Back to BLE mode
        } else {
            status_led_set_state(STATUS_LED_SOLID);
        }
        ESP_LOGI(TAG, "WiFi transfer disconnected - CAN data will stream over BLE");
    }

    // Notify app of state change via BLE
    cJSON *json = cJSON_CreateObject();
    cJSON_AddStringToObject(json, "type", "wifi_transfer_state");

    const char *state_str;
    switch (state) {
        case WIFI_TRANSFER_DISCONNECTED: state_str = "disconnected"; break;
        case WIFI_TRANSFER_CONNECTING:   state_str = "connecting"; break;
        case WIFI_TRANSFER_CONNECTED:    state_str = "connected"; break;
        case WIFI_TRANSFER_READY:        state_str = "ready"; break;
        case WIFI_TRANSFER_ERROR:        state_str = "error"; break;
        default:                         state_str = "unknown"; break;
    }
    cJSON_AddStringToObject(json, "state", state_str);
    send_json_response(json);
}

/**
 * @brief Handle data received over WiFi TCP connection
 *
 * Expects CAN frames in binary format:
 *   [1 byte: channel] [4 bytes: CAN ID big-endian] [1 byte: DLC] [8 bytes: data]
 *   = 14 bytes per frame
 */
static void on_wifi_transfer_receive(const uint8_t *data, size_t len)
{
    static int wifi_rx_frame_count = 0;

    // Process complete 14-byte CAN frames
    size_t offset = 0;
    int frames_in_batch = 0;
    while (offset + 14 <= len) {
        const uint8_t *frame = data + offset;

        uint8_t channel = frame[0];
        uint32_t can_id = (frame[1] << 24) | (frame[2] << 16) | (frame[3] << 8) | frame[4];
        uint8_t dlc = frame[5];
        const uint8_t *frame_data = &frame[6];

        // Validate
        if (channel > 1 || dlc > 8) {
            ESP_LOGW(TAG, "Invalid WiFi CAN frame: ch=%d dlc=%d", channel, dlc);
            offset += 14;
            continue;
        }

        wifi_rx_frame_count++;
        frames_in_batch++;

        // Log ETP CM frames (PF 0xC8) and TP CM frames (PF 0xEC) which include CTS
        uint8_t pf = (can_id >> 16) & 0xFF;
        if (pf == 0xC8 || pf == 0xEC) {
            ESP_LOGI(TAG, "WiFi->CAN TX: ETP CM ID=0x%08lX data=[%02X %02X %02X %02X %02X %02X %02X %02X]",
                     (unsigned long)can_id, frame_data[0], frame_data[1], frame_data[2], frame_data[3],
                     frame_data[4], frame_data[5], frame_data[6], frame_data[7]);
        }

        // Send the CAN frame (assume extended ID for ISOBUS)
        esp_err_t err = can_manager_send((can_channel_t)channel, can_id, frame_data, dlc, true);
        if (err != ESP_OK) {
            ESP_LOGW(TAG, "WiFi CAN TX failed: ID=0x%08lX err=%s", (unsigned long)can_id, esp_err_to_name(err));
        }

        offset += 14;
    }

    // Log every 10th batch to reduce noise
    if (wifi_rx_frame_count % 10 < frames_in_batch) {
        ESP_LOGI(TAG, "WiFi RX: %d frames total (%d in batch, %zu bytes)",
                 wifi_rx_frame_count, frames_in_batch, len);
    }

    if (offset < len) {
        ESP_LOGD(TAG, "WiFi RX: %zu trailing bytes", len - offset);
    }
}

// -----------------------------------------------------------------------------
// BLE Callbacks
// -----------------------------------------------------------------------------

static void on_ble_receive(const char *data, size_t len)
{
    ESP_LOGI(TAG, "BLE RX: %.*s", (int)len, data);

    // Reset request ID
    s_current_request_id = -1;

    cJSON *json = cJSON_ParseWithLength(data, len);
    if (json == NULL) {
        ESP_LOGW(TAG, "Invalid JSON received");
        send_error(1, "Invalid JSON");
        return;
    }

    // Extract request ID if present
    cJSON *id_item = cJSON_GetObjectItem(json, "id");
    if (cJSON_IsNumber(id_item)) {
        s_current_request_id = (int)id_item->valuedouble;
    }

    cJSON *cmd_item = cJSON_GetObjectItem(json, "cmd");
    if (!cJSON_IsString(cmd_item)) {
        ESP_LOGW(TAG, "Missing 'cmd' field");
        send_error(2, "Missing cmd");
        cJSON_Delete(json);
        return;
    }

    const char *cmd = cmd_item->valuestring;

    if (strcmp(cmd, "version") == 0) {
        handle_version_cmd();
    }
    else if (strcmp(cmd, "status") == 0) {
        handle_status_cmd();
    }
    else if (strcmp(cmd, "can_start") == 0) {
        handle_can_start_cmd();
    }
    else if (strcmp(cmd, "can_stop") == 0) {
        handle_can_stop_cmd();
    }
    else if (strcmp(cmd, "clear_buffer") == 0) {
        handle_clear_buffer_cmd();
    }
    else if (strcmp(cmd, "clear_stats") == 0) {
        handle_clear_stats_cmd();
    }
    else if (strcmp(cmd, "can_send") == 0) {
        handle_can_send_cmd(json);
    }
    else if (strcmp(cmd, "can_tx_mode") == 0) {
        handle_can_tx_mode_cmd(json);
    }
    else if (strcmp(cmd, "wifi_scan") == 0) {
        handle_wifi_scan_cmd();
    }
    else if (strcmp(cmd, "wifi_ota") == 0) {
        handle_wifi_ota_cmd(json);
    }
    else if (strcmp(cmd, "wifi_ota_abort") == 0) {
        handle_wifi_ota_abort_cmd();
    }
    else if (strcmp(cmd, "wifi_ota_local") == 0) {
        handle_wifi_ota_local_cmd(json);
    }
    else if (strcmp(cmd, "reboot") == 0) {
        handle_reboot_cmd();
    }
    else if (strcmp(cmd, "web_log") == 0) {
        handle_web_log_cmd(json);
    }
    else if (strcmp(cmd, "wifi_connect") == 0) {
        handle_wifi_connect_cmd(json);
    }
    else if (strcmp(cmd, "wifi_disconnect") == 0) {
        handle_wifi_disconnect_cmd();
    }
    else if (strcmp(cmd, "wifi_status") == 0) {
        handle_wifi_status_cmd();
    }
    else {
        ESP_LOGW(TAG, "Unknown command: %s", cmd);
        send_error(3, "Unknown command");
    }

    cJSON_Delete(json);
}

static void on_ble_connection_change(bool connected)
{
    ESP_LOGI(TAG, "BLE %s", connected ? "connected" : "disconnected");

    if (connected) {
        // BLE connected - check if WiFi transfer is active
        if (wifi_transfer_is_ready()) {
            // Keep 2Hz blink for WiFi mode
            status_led_set_state(STATUS_LED_BLINK_2HZ);
        } else {
            // BLE-only mode: slow 1Hz blink
            status_led_set_state(STATUS_LED_BLINK_1HZ);
        }
    } else {
        // BLE disconnected
        if (wifi_transfer_is_ready()) {
            // WiFi still active - keep 2Hz blink
            status_led_set_state(STATUS_LED_BLINK_2HZ);
        } else {
            // No connections: solid ON (waiting for connection)
            status_led_set_state(STATUS_LED_SOLID);
        }

        // Reset binary TX mode on disconnect
        if (s_can_tx_binary_mode) {
            ble_nus_set_binary_mode(false, NULL);
            ESP_LOGI(TAG, "Binary TX mode reset (sent %lu frames)",
                     (unsigned long)s_can_tx_frame_count);
            s_can_tx_binary_mode = false;
            s_can_tx_frame_count = 0;
        }

        // Abort WiFi OTA if disconnected
        if (wifi_ota_is_active()) {
            ESP_LOGW(TAG, "BLE disconnected during OTA, aborting...");
            wifi_ota_abort();
        }
    }
}

// -----------------------------------------------------------------------------
// WiFi OTA Callbacks
// -----------------------------------------------------------------------------

static void on_wifi_ota_progress(wifi_ota_status_t status, int progress,
                                  size_t received, size_t total, const char *message)
{
    const char *status_str;
    switch (status) {
        case WIFI_OTA_STATUS_CONNECTING_WIFI: status_str = "connecting_wifi"; break;
        case WIFI_OTA_STATUS_WIFI_CONNECTED:  status_str = "wifi_connected"; break;
        case WIFI_OTA_STATUS_DOWNLOADING:     status_str = "downloading"; break;
        case WIFI_OTA_STATUS_VALIDATING:      status_str = "validating"; break;
        case WIFI_OTA_STATUS_COMPLETE:        status_str = "complete"; break;
        case WIFI_OTA_STATUS_ERROR:           status_str = "error"; break;
        default:                              status_str = "idle"; break;
    }

    cJSON *json = cJSON_CreateObject();
    cJSON_AddStringToObject(json, "type", "wifi_ota_progress");
    cJSON_AddStringToObject(json, "status", status_str);
    cJSON_AddNumberToObject(json, "progress", progress);
    cJSON_AddNumberToObject(json, "received", received);
    cJSON_AddNumberToObject(json, "total", total);
    cJSON_AddStringToObject(json, "message", message ? message : "");
    send_json_response(json);
}

static void on_wifi_scan_result(const wifi_scan_result_t *results, size_t count,
                                 const char *error_msg)
{
    cJSON *json = cJSON_CreateObject();
    cJSON_AddStringToObject(json, "type", "wifi_scan_result");

    // Use saved request ID (not current, since scan is async)
    if (s_wifi_scan_request_id >= 0) {
        cJSON_AddNumberToObject(json, "id", s_wifi_scan_request_id);
        s_wifi_scan_request_id = -1;  // Clear after use
    }

    if (error_msg) {
        cJSON_AddBoolToObject(json, "success", false);
        cJSON_AddStringToObject(json, "error", error_msg);
    } else {
        cJSON_AddBoolToObject(json, "success", true);
        cJSON_AddNumberToObject(json, "count", count);

        cJSON *networks = cJSON_CreateArray();
        for (size_t i = 0; i < count; i++) {
            cJSON *net = cJSON_CreateObject();
            cJSON_AddStringToObject(net, "ssid", results[i].ssid);
            cJSON_AddNumberToObject(net, "rssi", results[i].rssi);
            cJSON_AddBoolToObject(net, "secured", results[i].authmode != 0);
            cJSON_AddItemToArray(networks, net);
        }
        cJSON_AddItemToObject(json, "networks", networks);
    }

    // Send directly without using send_json_response (which would add wrong id)
    char *str = cJSON_PrintUnformatted(json);
    if (str) {
        ble_nus_send(str, 0);
        free(str);
    }
    cJSON_Delete(json);
}

// -----------------------------------------------------------------------------
// CAN Data Streaming Task
// -----------------------------------------------------------------------------

// BLE notification congestion tracking
static uint32_t s_ble_notify_success = 0;
static uint32_t s_ble_notify_fail = 0;
static uint32_t s_ble_notify_backoff_ms = 20;  // Start with 20ms

// WiFi TX diagnostic counters
static uint32_t s_wifi_tx_ok = 0;
static uint32_t s_wifi_tx_fail = 0;
static uint32_t s_wifi_tx_batches = 0;
static uint32_t s_wifi_not_ready_count = 0;

static void can_stream_task(void *arg)
{
    ESP_LOGI(TAG, "CAN streaming task started");

    while (1) {
        bool wifi_ready = wifi_transfer_is_ready();
        bool ble_connected = ble_nus_is_connected();

        if ((wifi_ready || ble_connected) && can_manager_is_running()) {
            size_t count = can_buffer_count();
            if (count > 0) {
                if (wifi_ready) {
                    // WiFi mode: high throughput - read many messages at once
                    can_message_t msgs[32];
                    size_t read_count = can_buffer_read(msgs, 32);

                    if (read_count > 0) {
                        s_wifi_tx_batches++;
                        // Send each frame over WiFi TCP
                        int sent_ok = 0;
                        int send_fail = 0;
                        for (size_t i = 0; i < read_count; i++) {
                            esp_err_t err = wifi_transfer_send_can_frame(
                                msgs[i].id,
                                msgs[i].data,
                                msgs[i].dlc);
                            if (err == ESP_OK) {
                                sent_ok++;
                                s_wifi_tx_ok++;
                            } else {
                                send_fail++;
                                s_wifi_tx_fail++;
                            }
                        }
                        // Log TX stats every 100 batches (more frequent for debugging)
                        if (s_wifi_tx_batches % 100 == 0) {
                            ESP_LOGI(TAG, "WiFi TX stats: batches=%lu ok=%lu fail=%lu buf=%zu",
                                     (unsigned long)s_wifi_tx_batches,
                                     (unsigned long)s_wifi_tx_ok,
                                     (unsigned long)s_wifi_tx_fail,
                                     can_buffer_count());
                        }
                        // WiFi can handle high rates - minimal delay
                        vTaskDelay(pdMS_TO_TICKS(1));
                    } else {
                        vTaskDelay(pdMS_TO_TICKS(5));
                    }
                } else {
                    // BLE mode: limited throughput - read few messages with backoff
                    s_wifi_not_ready_count++;
                    // Log when WiFi not ready but BLE is (indicates wifi_transfer_is_ready returning false)
                    if (s_wifi_not_ready_count % 1000 == 1) {
                        ESP_LOGW(TAG, "WiFi not ready, using BLE (count=%lu, wifi_state=%d)",
                                 (unsigned long)s_wifi_not_ready_count,
                                 wifi_transfer_get_state());
                    }
                    can_message_t msgs[4];
                    size_t read_count = can_buffer_read(msgs, 4);

                    if (read_count > 0) {
                        // Send on dedicated CAN characteristic (UUID ...0004)
                        esp_err_t err = ble_nus_send_can((uint8_t*)msgs, read_count * sizeof(can_message_t));

                        if (err == ESP_OK) {
                            s_ble_notify_success++;
                            // Successful send - decrease backoff (min 15ms for BLE interval)
                            if (s_ble_notify_backoff_ms > 15) {
                                s_ble_notify_backoff_ms--;
                            }
                        } else {
                            s_ble_notify_fail++;
                            // Failed - increase backoff (max 100ms)
                            if (s_ble_notify_backoff_ms < 100) {
                                s_ble_notify_backoff_ms += 10;
                            }
                            // Log occasionally
                            if ((s_ble_notify_fail % 100) == 1) {
                                ESP_LOGW(TAG, "BLE notify congestion: %lu fails, backoff=%lums",
                                         (unsigned long)s_ble_notify_fail,
                                         (unsigned long)s_ble_notify_backoff_ms);
                            }
                        }

                        vTaskDelay(pdMS_TO_TICKS(s_ble_notify_backoff_ms));
                    } else {
                        vTaskDelay(pdMS_TO_TICKS(20));
                    }
                }
            } else {
                vTaskDelay(pdMS_TO_TICKS(wifi_ready ? 5 : 30));
            }
        } else {
            // Reset backoff when disconnected
            s_ble_notify_backoff_ms = 20;
            vTaskDelay(pdMS_TO_TICKS(100));
        }
    }
}

// -----------------------------------------------------------------------------
// Status Monitoring Task
// -----------------------------------------------------------------------------

static void status_task(void *arg)
{
    ESP_LOGI(TAG, "Status monitoring task started");

    while (1) {
        vTaskDelay(pdMS_TO_TICKS(30000));  // Every 30 seconds

        uint32_t can0_rx, can0_err, can1_rx, can1_err;
        uint32_t overflow, total;

        can_manager_get_stats(CAN_CHANNEL_0, &can0_rx, &can0_err);
        can_manager_get_stats(CAN_CHANNEL_1, &can1_rx, &can1_err);
        can_buffer_get_stats(&overflow, &total);

        ESP_LOGI(TAG, "CAN0: RX=%lu ERR=%lu | CAN1: RX=%lu ERR=%lu | Overflow=%lu Total=%lu | BLE=%s",
                 (unsigned long)can0_rx, (unsigned long)can0_err,
                 (unsigned long)can1_rx, (unsigned long)can1_err,
                 (unsigned long)overflow, (unsigned long)total,
                 ble_nus_is_connected() ? "connected" : "disconnected");
    }
}

// -----------------------------------------------------------------------------
// Main Application
// -----------------------------------------------------------------------------

void app_main(void)
{
    ESP_LOGI(TAG, "===========================================");
    ESP_LOGI(TAG, "  Perfect Vision ECU - CAN/BLE Bridge");
    ESP_LOGI(TAG, "  Firmware: %s", FIRMWARE_VERSION);
    ESP_LOGI(TAG, "===========================================");

    // Initialize NVS (required for BLE and WiFi)
    esp_err_t ret = nvs_flash_init();
    if (ret == ESP_ERR_NVS_NO_FREE_PAGES || ret == ESP_ERR_NVS_NEW_VERSION_FOUND) {
        ESP_ERROR_CHECK(nvs_flash_erase());
        ret = nvs_flash_init();
    }
    ESP_ERROR_CHECK(ret);

    // Initialize status LED early
    ret = status_led_init();
    if (ret != ESP_OK) {
        ESP_LOGW(TAG, "Status LED init failed: %s (continuing)", esp_err_to_name(ret));
    }

    // Mark current firmware as valid (for rollback protection)
    const esp_partition_t *running = esp_ota_get_running_partition();
    esp_ota_img_states_t ota_state;
    if (esp_ota_get_state_partition(running, &ota_state) == ESP_OK) {
        if (ota_state == ESP_OTA_IMG_PENDING_VERIFY) {
            ESP_LOGI(TAG, "First boot after OTA, marking firmware as valid");
            esp_ota_mark_app_valid_cancel_rollback();
        }
    }

    // Initialize relay control GPIO (may be needed for CAN channel routing)
    gpio_config_t relay_conf = {
        .pin_bit_mask = (1ULL << RELAY_CONTROL_GPIO),
        .mode = GPIO_MODE_OUTPUT,
        .pull_up_en = GPIO_PULLUP_DISABLE,
        .pull_down_en = GPIO_PULLDOWN_DISABLE,
        .intr_type = GPIO_INTR_DISABLE,
    };
    gpio_config(&relay_conf);
    gpio_set_level(RELAY_CONTROL_GPIO, 0);
    ESP_LOGI(TAG, "Relay control GPIO %d initialized (level=0)", RELAY_CONTROL_GPIO);

    // Initialize GPS module (for testing/logging)
    ret = gps_init();
    if (ret != ESP_OK) {
        ESP_LOGW(TAG, "GPS init failed: %s (continuing without GPS)", esp_err_to_name(ret));
    }

    // Initialize CAN manager
    ret = can_manager_init(CAN_BITRATE_250K);
    if (ret != ESP_OK) {
        ESP_LOGE(TAG, "CAN manager init failed: %s", esp_err_to_name(ret));
        return;
    }

    // Initialize BLE NUS
    ret = ble_nus_init(BLE_DEVICE_NAME_PREFIX, on_ble_receive);
    if (ret != ESP_OK) {
        ESP_LOGE(TAG, "BLE NUS init failed: %s", esp_err_to_name(ret));
        return;
    }
    ble_nus_set_connection_callback(on_ble_connection_change);

    // Initialize WiFi transfer (for high-speed data streaming)
    ret = wifi_transfer_init(on_wifi_transfer_receive);
    if (ret != ESP_OK) {
        ESP_LOGW(TAG, "WiFi transfer init failed: %s (continuing without WiFi)", esp_err_to_name(ret));
    } else {
        wifi_transfer_set_state_callback(on_wifi_transfer_state_change);
        wifi_transfer_set_debug_callback(send_debug);
        ESP_LOGI(TAG, "WiFi transfer initialized");
    }

    ESP_LOGI(TAG, "Device name: %s", ble_nus_get_device_name());
    ESP_LOGI(TAG, "Firmware hash: %s", get_firmware_hash());

    // Start CAN reception
    ret = can_manager_start();
    if (ret != ESP_OK) {
        ESP_LOGE(TAG, "CAN manager start failed: %s", esp_err_to_name(ret));
        return;
    }

    // Create tasks
    xTaskCreate(can_stream_task, "can_stream", 4096, NULL, 5, NULL);
    xTaskCreate(status_task, "status", 2048, NULL, 1, NULL);

    ESP_LOGI(TAG, "System initialized successfully");
    ESP_LOGI(TAG, "CAN0: TWAI (TX=%d, RX=%d)", CAN0_TX_GPIO, CAN0_RX_GPIO);
    ESP_LOGI(TAG, "CAN1: MCP2515 (CS=%d, INT=%d)", MCP2515_CS_GPIO, MCP2515_INT_GPIO);
    ESP_LOGI(TAG, "GPS: UART%d (TX=%d, RX=%d)", GPS_UART_NUM, GPS_TX_GPIO, GPS_RX_GPIO);

    // Setup complete: solid LED ON
    status_led_set_state(STATUS_LED_SOLID);

    ESP_LOGI(TAG, "Waiting for BLE connection...");
}
