phellberg76/Perfect-Vision-ECU/(commit log)

2026-07-06 Initial commit: Raspberry Pi Backup power and GPS hat v4
    KiCad project files for a Raspberry Pi hat with backup power,
    GPS, 2-channel CAN, and automotive ethernet functionality.
    [2-channel-CAN.kicad_sch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]
2026-08-04 Add ESP32 firmware with GPS relay and deploy scripts
    - ESP32 firmware reads NMEA from NEO-M9N GPS
    - Relays position data to RPi via USB serial
    - SPI pins set as inputs to avoid bus contention with MCP2515
    - Output modes: raw NMEA, filtered, or JSON
    - Deploy script for pulling and flashing from RPi
    - RPi setup script for one-time PlatformIO installation
    [esp32.kicad_sch, gps.kicad_sch]
2026-08-04 Fix deploy scripts for PEP 668 (externally-managed-environment)
    Use Python venv instead of system-wide pip install for PlatformIO.
    Required for newer Raspberry Pi OS / Debian 12+.
2026-08-04 Move firmware source to src/ for PlatformIO compatibility
    - Renamed firmware.ino to src/main.cpp
    - Added Arduino.h include for .cpp compilation
    - Moved pins.h to src/
2026-08-04 Add forward declarations to main.cpp
    Required for C++ compilation (Arduino IDE auto-generates these for .ino files).
2026-08-04 Configure flashing via RPi UART with GPIO reset control
    Hardware connections:
    - RPi UART (ttyAMA0) -> ESP32 UART
    - RPi GPIO17 -> ESP32 EN (reset)
    - RPi GPIO27 -> ESP32 IO0 (boot mode select)
    Deploy script now controls GPIO17/27 to enter bootloader mode
    before flashing via esptool.
2026-08-04 Support both USB and UART programming methods
    - Auto-detects USB device (ttyACM*/ttyUSB*) or falls back to UART
    - ./deploy.sh upload usb - Force USB method
    - ./deploy.sh upload uart - Force UART with GPIO control
    - ./deploy.sh upload - Auto-detect best method
    USB is simpler as esptool handles reset automatically.
    UART requires GPIO17/27 control for bootloader mode.
2026-08-05 Fix: Use UART0 for RPi communication instead of USB CDC
    The ESP32 was sending output to USB CDC (Serial) but the RPi is
    connected via UART0 (TXD0/RXD0 = GPIO43/44).
    Changes:
    - Use HardwareSerial(0) for RPi communication on UART0
    - GPS remains on HardwareSerial(1) / UART1
    - All RPI_Serial output now goes to /dev/ttyAMA0 on the RPi
2026-08-05 Add debug heartbeat message every 2 seconds
    Outputs JSON with uptime and GPS statistics to help debug
    UART and GPS communication issues.
2026-08-05 Remove debug heartbeat - GPS communication working
    GPS baud rate confirmed at 38400. NMEA sentences flowing correctly.
    Removed debug output for production firmware.
2026-08-05 Add JSON protocol for ESP32 <-> RPi communication
    Features:
    - GPS data sent as JSON every 1 second (configurable)
    - Heartbeat messages every 5 seconds with status
    - Watchdog support (PING/PONG and timeout detection)
    - Sleep/wake commands with deep sleep support
    - Configurable GPS update rate
    - Raw NMEA passthrough mode for debugging
    Commands:
    - PING -> PONG (simple watchdog)
    - STATUS - request heartbeat
    - SLEEP / {"cmd":"sleep","seconds":60}
    - WATCHDOG_ON/OFF
    - GPS_RAW_ON/OFF
    - RESET
2026-08-05 Add ESP-Hosted WiFi coprocessor documentation and overlay
    Pin mapping for ESP32-S3 as SPI slave WiFi coprocessor:
    - CS: RPi GPIO4 -> ESP32 IO10
    - Handshake: RPi GPIO5 -> ESP32 IO3
    - Data Ready: RPi GPIO6 -> ESP32 IO4
    - Reset: RPi GPIO17 -> ESP32 EN
    Includes device tree overlay and setup instructions.
2026-08-05 Update ESP-Hosted overlay for SPI bus sharing with CAN
    SPI bus shared between:
    - CE0 (GPIO8) -> MCP2515 CAN0
    - CE1 (GPIO7) -> MCP2515 CAN1
    - CE2 (GPIO4) -> ESP32 SPI slave
    Device tree overlay configures GPIO4 as third chip select,
    allowing all three devices to coexist.
2026-08-05 Add unified GPS + WiFi + PPP firmware with SPI slave interface
    - Refactor main.cpp to support SPI slave for GPS/status communication
    - Add PPP server implementation for WiFi network sharing to RPi
    - Add RPi Python library for SPI communication with ESP32
    - Add device tree overlay for ESP32 as third SPI device (CE2/GPIO4)
    - Add setup and test scripts for RPi integration
    - Update platformio.ini with NAPT/IP forwarding flags
    Architecture:
    - UART0: PPP for WiFi network sharing
    - SPI Slave: GPS JSON, status, WiFi config commands
    - UART1: GPS module (NEO-M9N)
2026-08-05 Fix UART initialization order - init before SPI
    - Move PPP_Serial.begin() to start of setup()
    - Add debug messages during initialization
    - Add heartbeat message every 5 seconds when not in PPP mode
    This fixes crash caused by SPI error trying to print before UART initialized.
2026-08-05 Add status LED on IO46 - lights up when setup complete
    LED is active HIGH, turns on at end of setup() to indicate healthy operation.
2026-08-05 Reset serial port baud rate before UART flashing
    Fixes upload failures when serial port was previously configured
    to a different baud rate during testing.
2026-08-05 Add ESP32 PPP startup script for rc.local
    Reads WiFi credentials from environment variables:
    - ESP32_WIFI_SSID
    - ESP32_WIFI_PASS
    - ESP32_PPP_ENABLE (set to "1" to start PPP)
2026-08-06 Fix ESP32 detection in PPP startup script
    - Look for heartbeat messages instead of STATUS response
    - Use heartbeat wifi field to detect WiFi connection
    - Better timeout handling for serial reads
2026-08-06 Simplify ESP32 detection using read builtin
    Use bash read with timeout instead of head/cat for more reliable serial reading.
2026-08-06 Fix WiFi detection to use read builtin
    Use same read approach that worked for ESP32 detection.
    Also log heartbeat messages for debugging.
2026-08-06 Fix PPP FCS calculation and add USB debug logging
    - Fix critical bug: FCS now includes Address+Control bytes (RFC 1662)
    - Fix blocking issue in PPP frame reception (use state variable)
    - Enable USB CDC for separate debug channel (USB=debug, UART0=PPP)
    - Add debug logging throughout PPP negotiation
    - Add SLIP server as simpler alternative to PPP
    - Add ppp-test.sh for manual PPP debugging
2026-08-06 Fix PPP: send Config-Req after receiving peer's Config-Req
    The initial Config-Req was sent before pppd started, so it was lost.
    Now ESP32 re-sends its Config-Req when it receives one from pppd.
    Added LCP_OPEN state for proper state tracking.
2026-08-06 Add Protocol-Reject for CCP and IPV6CP
    ESP32 now properly rejects unsupported protocols (compression,
    IPv6) instead of ignoring them, preventing pppd timeouts.
2026-08-06 Add ICMP echo reply handling for ping to ESP32
    ESP32 now responds to ICMP echo requests (pings) to 10.0.0.1.
    Added debug logging for IP packet handling.
2026-08-06 Improve IP forwarding with NAT and debug logging
    - Replace source IP with ESP32 WiFi IP for outgoing packets
    - Track ICMP ID for return path (WIP)
    - Route via gateway for external destinations
    - Add detailed debug logging
    Note: Return path (incoming responses) not yet implemented.
2026-08-06 Add cleanup_serial to deploy script for PPP recovery
    Before flashing via UART:
    - Kill any running pppd processes
    - Release serial port with fuser
    - Reset serial port settings
    - Reset ESP32 via GPIO to exit PPP mode
    This allows re-flashing without rebooting after PPP usage.
2026-08-06 Change deploy auto-detection to prefer UART
    UART is always available on this board, so use it by default.
    USB can still be explicitly selected with: ./deploy.sh upload usb
2026-08-10 Add HTTP proxy via ESP32 AP mode
    ESP32 runs as WiFi AP and HTTP server. Forwards all HTTP requests
    to RPi over UART, where a Python daemon curls localhost and returns
    the response. This provides a reliable hotspot using ESP32's stable
    AP mode instead of the problematic BCM43455 concurrent AP+STA.
    New commands:
    - HTTP_PROXY_START - Start with default SSID "GPS-Hat"
    - HTTP_PROXY_START ssid pass - Start with custom credentials
    - HTTP_PROXY_STOP - Stop the proxy
2026-08-10 Add web interface for WiFi/cellular status and provisioning
    - Shows WiFi connection status (SSID, IP, signal strength)
    - Shows cellular modem status (operator, technology, signal)
    - Allows scanning for available WiFi networks
    - Allows connecting to new WiFi networks via form
    - Dark theme, mobile-friendly UI
    - Runs on port 80, accessed via ESP32 HTTP proxy
2026-08-10 Fix web interface template - use Template instead of format()
    CSS curly braces were conflicting with Python's .format() method.
    Switched to string.Template with $variable syntax.
2026-08-10 Auto-start HTTP proxy AP on boot
    ESP32 now automatically starts the WiFi AP with SSID "PerfectVisionPlanter"
    and password "12345678" when it boots, removing the need to send the
    HTTP_PROXY_START command manually.
2026-08-11 Change HTTP proxy to port 8080 for planter app compatibility
    The Flutter planter app expects the backend on port 8080. Updated:
    - ESP32 HTTP server: port 80 -> 8080
    - web_interface.py: port 80 -> 8080
    - http-proxy.service: target localhost:80 -> localhost:8080
2026-08-11 Use nginx as reverse proxy instead of port 8080
    Better architecture using nginx to route requests:
    - ESP32 HTTP proxy stays on port 80
    - nginx on port 80 routes:
    - /planter_app/* -> planter app on port 8080
    - /* -> web_interface on port 8081
    - http-proxy daemon forwards to nginx on port 80
2026-08-11 Fix HTTP proxy issues - suppress debug logs and encode URLs
    1. Suppress ESP32 core debug logging (CORE_DEBUG_LEVEL=0) to prevent
    debug messages from corrupting UART protocol
    2. URL-encode paths in daemon to handle spaces in query parameters
2026-08-11 Increase ESP32 UART RX buffer to 4KB for large JSON responses
    The default 256-byte RX buffer was causing data loss when receiving
    large HTTP responses (like getPlanterConfig at 1332 bytes). This
    resulted in truncated/corrupted responses being sent to the phone.
2026-08-11 Filter hop-by-hop headers in HTTP proxy response
    Skip Transfer-Encoding, Content-Length, Connection, and Keep-Alive
    headers when forwarding responses from RPi to client. These headers
    conflict with ESP32 WebServer's own encoding (Content-Length based).
    Fixes "47 is expected to be a Hex digit" error in Flutter client caused
    by Transfer-Encoding: chunked header being forwarded while body is sent
    with Content-Length encoding.
2026-08-28 Replace WiFi/PPP with BLE bridge for Flutter app communication
    New architecture: Flutter App <--BLE--> ESP32 <--UART--> RPi <--HTTP--> Backend
    - Add ble_bridge.h/cpp using NimBLE-Arduino for GATT server
    - Simplify main.cpp to GPS + BLE only (removed WiFi/PPP/SLIP/HTTP proxy)
    - Update platformio.ini with NimBLE-Arduino dependency
    - Same service UUIDs as original Rust bridge for app compatibility
    The ESP32 now handles BLE communication with the Flutter app,
    forwarding JSON messages to the RPi via UART for HTTP proxying.
2026-08-28 Fix NimBLE callback signatures and remove old WiFi/PPP files
    - Update callback signatures to match NimBLE-Arduino 1.4.x API
    - Remove http_proxy, ppp_server, slip_server (no longer needed)
    - BLE bridge now uses simpler callback signatures without connInfo
2026-08-28 Remove non-existent security fields from bluer characteristics
    The bluer crate's CharacteristicWrite and CharacteristicNotify
    don't have encrypt_*/secure_* fields - removed them.
    [2-channel-CAN.kicad_sch, BOM-Raspberry-Pi-Backup-power-and-GPS-hat-v4.csv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]
2026-08-28 Add RPi UART bridge (formerly planter-ble-bridge)
    Consolidate the RPi bridge into this repo under firmware/rpi-bridge.
    This handles UART communication with ESP32 and HTTP proxying to backend.
    Flutter App <--BLE--> ESP32 <--UART--> RPi bridge <--HTTP--> Backend
    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
2026-08-31 Add cloud compilation and deployment scripts
    - compile.sh: Build firmware on cloud server using PlatformIO
    - update_from_cloud.sh: Fetch and flash pre-compiled firmware to ESP32
2026-08-31 Add comprehensive build and deploy scripts
    - compile_all.sh: Build ESP32, Rust, and Java on cloud server
    - update_all_from_cloud.sh: Fetch and deploy all components to Pi
    Supports building/updating individual components or all at once.
2026-08-31 Reduce flash baud rate for stability
    Lower baud rate from 460800 to 230400 to improve
    flashing reliability over UART.
2026-08-31 Improve service handling and add delays for serial port release
    - Always stop planter-ble-bridge before flashing (don't check first)
    - Add delays after stopping services for serial port release
    - Restart planter-ble-bridge after ESP32 flash completes
2026-08-31 More conservative flash settings for stability
    - Reduce baud to 115200, flash_freq to 40m
    - Suppress fuser output properly
    - Add stty to reset serial port before flashing
2026-08-31 Add missing http-proxy.service stop and ESP32 PPP reset
    Matches deploy.sh behavior:
    - Stop http-proxy.service before flashing
    - Reset ESP32 to exit PPP mode before entering bootloader
    - Restart http-proxy.service after flashing if enabled
2026-08-31 Fix message interleaving in BLE and UART writes
    Add flush() calls after write_all() to ensure each message is fully
    transmitted before starting the next. For BLE, also add a small delay
    to allow the transport layer to complete notification transmission.
    This fixes JSON parse errors in the Flutter app caused by large
    messages being fragmented and interleaved at the transport layer.
2026-08-31 Add mutex to prevent interleaved BLE sends on ESP32
    sendToClient() sends large messages in multiple chunks with delays
    between them. Without synchronization, concurrent calls could
    interleave their chunks, corrupting messages.
    Added FreeRTOS mutex to ensure only one message is sent at a time.
2026-08-31 Increase UART buffers to prevent overflow, reduce BLE delays
    - Increase hardware UART RX buffer from 4KB to 32KB
    - Increase internal message buffer limit from 4KB to 32KB
    - Reduce inter-chunk delay from 20ms to 10ms
    - Reduce post-message delay from 50ms to 20ms
    The larger buffers accommodate the BLE send delays without overflow.
2026-09-01 Reduce buffer sizes to prevent ESP32 crash
    32KB buffers caused out-of-memory crashes. Reduced to 8KB which
    should be sufficient for most API responses while staying within
    ESP32-S3 RAM limits.
2026-09-01 Revert to original 4KB buffer, remove post-message delay
    The larger buffers caused ESP32 crashes (out of memory).
    Reverting to original 4KB buffer size.
    Removed the post-message delay as it contributed to buffer overflow.
    The mutex should be sufficient to prevent concurrent sends.
2026-09-01 Remove USB CDC flags that may cause ESP32-S3 crashes
    The ARDUINO_USB_CDC_ON_BOOT and ARDUINO_USB_MODE flags can cause
    boot issues on some ESP32-S3 configurations. Removed to match
    the working Diesel dispenser configuration.
2026-09-01 Fix BLE message interleaving: increase delays and process one UART msg per loop
    - Increase inter-chunk delay from 10ms to 20ms
    - Increase post-message delay from 20ms to 100ms (delay + vTaskDelay)
    - Increase mutex timeout from 1s to 5s
    - Add vTaskDelay between chunks to yield to BLE stack
    - Process only one UART message per processUart() call to give BLE
    stack time to transmit before next message
2026-09-04 Add WiFi support and UART command handling
    - Add WiFi station mode with credential storage (NVS)
    - Send GPS data periodically via UART to RPi bridge
    - Send WiFi status periodically via UART
    - Handle UART commands: wifi_status, wifi_config, wifi_disconnect, gps_status
    - Add ArduinoJson library for command parsing
    - Bump version to 3.1.0
2026-09-04 Add WiFi/GPS handling to Rust bridge via ESP32 UART
    - Add esp32_state module for caching GPS/WiFi state from ESP32
    - Intercept getWifiStatus and configureWifi requests in http_proxy
    - Parse ESP32 messages (GPS, WiFi, heartbeat) in main event loop
    - Send commands to ESP32 via UART for WiFi configuration
    - Add urlencoding dependency for parsing query parameters
2026-09-04 Fix BLE response forwarding: route UART responses to BLE client
    The processUartCommands() function was consuming all UART data including
    BLE responses from the RPi bridge. Messages without a "cmd" field were
    silently discarded, causing BLE request timeouts in the Flutter app.
    Now messages without "cmd" are forwarded to the BLE client via
    bleBridge.sendToClient(). Also increased UART buffer to 32KB for large
    HTTP responses.
2026-09-04 Use RPi WiFi status/config instead of ESP32
    - WiFi status now queries RPi using nmcli instead of ESP32 state
    - WiFi configure now uses nmcli to connect RPi to networks
    - Removed unused ESP32 WiFi constants and imports
2026-09-09 Add checksum-based download skipping to update script
    - Compare MD5 hashes of local and remote files before downloading
    - Only download files that have actually changed
    - Add hash cache for ESP32 firmware (stored in /var/cache/planter-update)
    - Add --force flag to bypass checksum comparison when needed
    - Update all component functions (ESP32, Rust, Java) to use smart downloads
2026-09-09 Fix BLE message interleaving in ESP32 firmware
    - Disable redundant UART reading in processUart() since
    processUartCommands() in main.cpp already handles all UART->BLE
    forwarding. Having two code paths reading from the same serial
    port could cause race conditions.
    - Increase post-message delay from 50+50ms to 100+100ms to ensure
    NimBLE stack fully transmits all queued notifications before the
    next message starts. notify() queues data asynchronously.
    - Increase inter-chunk delay from 20ms to 30+10ms for more reliable
    chunk transmission.
2026-09-09 Forward GPS from ESP32 to Java backend via HTTP POST
    When GPS data is received from ESP32 via UART, forward it to the
    Java backend's /updateGpsFromBridge endpoint. This provides fallback
    GPS/speed data when ISOBUS GPS is not available.
2026-09-09 Add diagnostic logging for GPS message tracing
    Log GPS/WiFi messages at info level to trace where they get lost.
2026-09-09 Reduce BLE send delays to allow GPS updates more frequently
    The long delays (200ms total per message) were blocking the ESP32
    main loop, preventing GPS from being sent to RPi while BLE responses
    were being transmitted.
    Reduced to 40ms total per message to allow GPS updates every second.
2026-09-09 Fix ESP32 update to download all binaries when any changes
    The flash command requires all 3 binaries (bootloader, partitions,
    firmware). Previously, unchanged files were skipped, causing flash
    to fail when only some files changed.
    Now downloads all 3 files when any one changes.
2026-09-09 Add BLE message queue to prevent interleaving (v3.4.0)
    - Implement FreeRTOS queue for outgoing BLE messages
    - Process queue sequentially with 50ms minimum gap between messages
    - Increase chunk delays (15ms+10ms) and post-message delay (30ms+30ms)
    - Clear queue on client disconnect
    - Add RPi watchdog monitoring via GPIO heartbeat
    - Add BLE admin commands (reboot_rpi, esp32_status)
    - Add ESP32 hardware watchdog for self-monitoring
    - Fix esp_task_wdt API for Arduino-ESP32 compatibility
    Fixes issue where BLE notifications from multiple messages were
    interleaving, causing JSON parse errors on the Flutter client.
2026-09-09 Add UART heartbeat to Rust bridge for ESP32 watchdog (v0.4.0)
    Sends wdt_pet command every 5 seconds to keep ESP32 watchdog happy.
    Only sends heartbeat if Java backend is reachable, ensuring the
    whole stack (Rust bridge + Java backend) is healthy before petting.
2026-09-10 Move IO4 init to start of setup() with internal pull-up
    Initialize the reset pin (IO4) as INPUT_PULLUP at the very beginning
    of setup() to prevent it from holding GLOBAL_EN low during boot.
    This should allow the RPi to boot with the GLOBAL_EN jumper in place.
2026-09-10 Add smart rebuild detection to compile_all.sh
    - Moves git pull into the script
    - Tracks commit hashes before/after pull
    - Only rebuilds components whose source files changed:
    - ESP32: src/, platformio.ini
    - Rust: rpi-bridge/
    - Java: src/, pom.xml
    - Add 'force' option to rebuild everything
    - Prevents WAR file from getting new MD5 when unchanged
2026-09-10 Change reset pin from IO4 to IO10
    IO4 appears to go LOW during ESP32 boot, preventing RPi from booting
    when GLOBAL_EN jumper is connected. Testing IO10 as alternative.
2026-09-10 Fix GLOBAL_EN logic level mismatch - use true open-drain
    GLOBAL_EN expects 5V logic with internal 100k pull-up to 5V.
    Using INPUT_PULLUP (3.3V) was likely being seen as LOW.
    - Use INPUT (no pull-up) instead of INPUT_PULLUP
    - Let GLOBAL_EN's internal pull-up do the work
    - triggerReset() now goes directly from OUTPUT LOW to INPUT
    (no intermediate HIGH which would be 3.3V)
    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
2026-09-10 Revert to IO4/GPIO6 for reset pin
2026-09-10 Update reset logic for NPN transistor circuit
    External circuit: GPIO6 -> 1k -> Base, 10k pull-down, Collector -> GLOBAL_EN, Emitter -> GND
    Logic is inverted:
    - GPIO LOW/floating: 10k keeps transistor OFF, GLOBAL_EN HIGH (normal)
    - GPIO HIGH: transistor ON, GLOBAL_EN pulled LOW (reset)
2026-09-10 Change reset circuit to 4N25 optocoupler with active-low logic
    Active-low design is inherently safe: GPIO floating/HIGH keeps LED OFF,
    only explicit LOW drive triggers reset. This avoids boot issues caused
    by undefined GPIO states.
2026-09-11 Add USB logging for watchdog monitoring
    Logs watchdog status every 5 seconds via USB Serial:
    - Current status (OK, WARNING, GRACE, DISABLED)
    - Heartbeat pin state (HIGH/LOW)
    - Time since last pulse
    - Pulse count and delta since last log
    - Timeout threshold and reset count
2026-09-11 Add HTTP server for Java watchdog endpoint
    - Add warp dependency for HTTP server
    - Spawn HTTP server on port 8081 with /petWatchdog endpoint
    - Remove automatic heartbeat generation
    - Java now explicitly calls /petWatchdog which forwards to ESP32
    This ensures both Java AND the bridge must be healthy for ESP32 watchdog.
2026-09-11 Remove GPIO-based watchdog, use software heartbeat only
    - Remove PIN_WDT_HEARTBEAT (IO3) and GPIO interrupt handler
    - Watchdog now relies solely on UART wdt_pet commands from RPi
    - Simplify processWatchdog() logging (no more pulse counting)
    - Flow: Java -> Bridge HTTP -> UART -> ESP32 wdt_pet command
    This ensures both Java AND the bridge must be healthy for heartbeat.
2026-09-11 Auto-install esptool in venv for PEP 668 compliance
    Newer Raspberry Pi OS enforces externally-managed-environment.
    Script now creates a venv and installs esptool automatically if not found.
2026-09-11 Disable ESP32 watchdog during updates
    Sends wdt_disable to ESP32 before updating, wdt_enable after.
    Prevents watchdog reset while downloading/installing components.
2026-09-11 Add HTTP endpoints for watchdog disable/enable
    - Add /disableWatchdog and /enableWatchdog to bridge HTTP server
    - Update deploy script to use HTTP instead of direct UART
    - Direct UART doesn't work when bridge has port open
2026-09-11 Stop bridge before disabling watchdog via UART
    Simpler approach - stop bridge to free UART, send disable command directly.
2026-09-12 Add shutdown monitor service for graceful shutdown
    Creates a systemd service that watches for /tmp/shutdown and /tmp/reboot
    files created by the Java app. When detected, it:
    1. Disables ESP32 watchdog via bridge HTTP endpoint
    2. Stops Tomcat gracefully (triggers destroy())
    3. Stops BLE bridge
    4. Executes shutdown/reboot
    This prevents the ESP32 watchdog from resetting the RPi when it's
    intentionally sleeping after data sync.
    Deploy script now auto-installs the shutdown monitor service.
2026-09-12 Add ignition sensing (tractor power detection)
    ESP32:
    - Monitor GPIO34 via ADC (470k/100k voltage divider from 12V ignition)
    - Debounce ignition state changes (500ms)
    - Send {"type":"ignition","on":true/false,"adc":value} to RPi via UART
    Rust bridge:
    - Parse Ignition messages from ESP32
    - Forward to Java tractorPower endpoint: GET /service/tractorPower?on={true|false}
    This enables the Java app to detect tractor power state and trigger
    graceful shutdown when tractor is off and data is synced.
2026-09-19 Rename project to Perfect-Vision-ECU
    - Rename main project files from Raspberry-Pi-Backup-power-and-GPS-hat-v4
    - Update relay footprint to G6K-2F-Y to match LCSC part C397194
    - Update C4 capacitor to CP_Elec_8x10.5 with LCSC C3353 (220uF 25V)
    - Add new power supply schematic
    - Update JLCPCB production files (gerbers, BOM, CPL)
    - Remove old firmware and Raspberry Pi specific files
    [2-channel-CAN.kicad_sch, BOM-Perfect-Vision-ECU.csv, BOM-Raspberry-Pi-Backup-power-and-GPS-hat-v4.csv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]
2026-09-19 Fix JLCPCB component rotations
    - U3 (LM2596S-3.3): 0° → 180°
    - J5 (USB-C connector): 180° → 0°
    [CPL-Perfect-Vision-ECU.csv]
2026-09-21 Add tmp*.rpt to gitignore
    Exclude temporary report files generated by KiCad.
2026-10-13 Add deploy.sh script for ESP32-S3 firmware deployment
2026-10-20 Add ESP32-S3 firmware with GPS, dual CAN, BLE, and WiFi OTA
    - Complete ESP-IDF project for Perfect Vision ECU
    - Dual CAN bus support (internal TWAI + external MCP2515)
    - GPS module with NMEA parsing (NEO-M9N)
    - BLE Nordic UART Service for app communication
    - WiFi OTA firmware update support
    - compile.sh for cloud server CI/CD builds
    [partitions.csv]
2026-10-20 Fix ESP-IDF 5.2 compatibility for component dependencies
    - Remove esp_driver_spi, esp_driver_gpio from mcp2515 (part of driver in 5.2)
    - Remove esp_driver_uart from main (part of driver in 5.2)
2026-10-20 Add missing string.h include in can_manager.c
    [can_manager.c]
2026-10-21 Fix WiFi scan response ID and use X-Firmware-Key header
    - Save wifi_scan request ID for async callback (fixes wrong ID in response)
    - Use X-Firmware-Key header instead of Authorization: Bearer for firmware downloads
    - Ensures Flutter app receives correct response ID for wifi_scan_result
    [main.c, wifi_ota.c]
2026-10-21 Update CMakeLists.txt for ESP-IDF 6.x compatibility
    - Use separate driver components (esp_driver_uart, esp_driver_gpio, etc.)
    - Required for ESP-IDF 6.1 which restructured driver components
2026-10-21 Update can_manager.c for ESP-IDF 6.x TWAI API
    - Use esp_twai.h and esp_twai_onchip.h instead of driver/twai.h
    - Required for ESP-IDF 6.1 new TWAI driver API
2026-10-21 Fix OTA Content-Length and bump version to 1.0.3
    - Use esp_https_ota_get_image_size() for proper file size reporting
    - Pass API key as URL query parameter instead of header
    - Add skip_cert_common_name_check for certificate flexibility
    - Increase timeout to 60s for large firmware files
    - Bump version from 1.0.1 to 1.0.3
    [wifi_ota.c]
2026-10-21 Fixes 20/10/2026
    [2-channel-CAN.kicad_sch, BOM-Perfect-Vision-ECU.csv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]
2026-10-22 Add status LED on GPIO46 and bump version to 1.0.5
    - Solid ON after setup complete
    - 1Hz blink when BLE connected
    - 10Hz blink on CAN or BLE errors (auto-reverts after 2s)
    [ble_nus.c, can_manager.c, main.c, pin_config.h, status_led.c]
2026-10-23 feat: Add CAN TX support via BLE
    Add two methods for transmitting CAN frames from the app to the bus:
    1. JSON command (can_send):
    {"cmd":"can_send","ch":1,"id":123456,"ext":true,"dlc":8,"data":[...]}
    Good for debugging and low-frequency messages.
    2. Binary TX mode (can_tx_mode):
    Enable with {"cmd":"can_tx_mode","enabled":true}
    Then send raw 19-byte frames (same format as RX stream).
    More efficient for high-frequency VT traffic (~5x less overhead).
    The BLE NUS module already discriminates between JSON commands
    (starting with {"cmd) and binary frames (starting with channel byte).
    Also resets binary mode on BLE disconnect for clean state.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
    [main.c]
2026-10-23 Add web-based log viewer and bump version to 1.0.6
    - Add web_log module: WiFi AP + HTTP server for viewing ESP32 logs
    - Creates AP: PV_LOG_XXXXXX (password: pvdebug123)
    - Serves color-coded logs at http://192.168.4.1/
    - 32KB ring buffer, auto-refresh every 5 seconds
    - Add BLE command "web_log" to start/stop log server
    - Bump firmware version to 1.0.6
2026-10-23 Fix can_tx_mode response bug, bump to 1.0.7
    Send OK response before enabling binary mode to ensure the response
    is transmitted while still in JSON mode. The mode change was blocking
    the response from being sent.
    [main.c]
2026-10-23 Add delay after can_tx_mode response, bump to 1.0.8
    The BLE send is asynchronous - need to wait for the response to be
    transmitted before enabling binary mode, otherwise the mode change
    interferes with the response transmission.
    [main.c]
2026-10-23 Add adaptive backoff for BLE CAN notifications
    Reduce notification drops during ISOBUS pool uploads by:
    - Reducing batch size from 8 to 4 frames (76 bytes fits BLE MTU better)
    - Implementing adaptive backoff: starts at 20ms, increases on failure
    (up to 100ms), decreases on success (down to 15ms)
    - Adding congestion tracking and periodic logging
    [main.c]
2026-10-23 Include newline in BLE data instead of separate notification
    When sending JSON messages over BLE, the newline terminator was sent
    as a separate notification that could be lost. Now the newline is
    appended to the data buffer before chunking, ensuring it's sent
    atomically with the last chunk of data.
    This fixes JSON parsing errors when the newline was lost and messages
    got concatenated (e.g., wifi_scan_result + CAN frame sent).
    [ble_nus.c]
2026-10-23 BLE throughput improvements: MTU tracking and connection params
    - Track current MTU and use it for dynamic chunk sizing
    - Set preferred MTU to 512 bytes (client initiates exchange)
    - Request faster connection parameters (7.5-15ms interval, 0 latency)
    - Reset MTU to default on disconnect
    [ble_nus.c]
2026-10-23 Add WiFi transfer mode for high-speed CAN streaming
    ESP32-S3 doesn't support Bluetooth Classic, so implement WiFi-based
    high-throughput data transfer as an alternative to BLE.
    - BLE (NimBLE): Control plane - commands, status, WiFi provisioning
    - WiFi TCP: Data plane - CAN streaming via phone's hotspot (~10+ Mbps)
    New BLE commands:
    - wifi_connect: Connect to phone's hotspot and establish TCP
    - wifi_disconnect: Disconnect from WiFi
    - wifi_status: Query connection state and stats
    - Automatic transport selection (WiFi preferred, BLE fallback)
    - 2Hz LED blink indicates WiFi high-speed mode
    - State change notifications over BLE
    - Binary CAN frame format over TCP (14 byte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
    [main.c, status_led.c, wifi_transfer.c]
2026-10-23 Add TODO note for OTA relay via tablet hotspot
    Document potential feature to use the existing WiFi hotspot
    connection for OTA updates, eliminating need for separate
    WiFi credential provisioning.
2026-10-23 Add BLE debug logging for WiFi transfer
    Send detailed debug messages over BLE during WiFi/TCP connection
    process to help diagnose connection issues from the Flutter app.
    - Add wifi_transfer_debug_callback_t for debug messages
    - Add debug_log() helper that sends to both ESP_LOG and BLE
    - Log SSID, target IP/port, assigned IP, and TCP connection status
    - Add 'debug' message type handling in Flutter BLE service
    [main.c, wifi_transfer.c]
2026-10-26 Disable WiFi transfer to fix OTA conflict (v1.2.1)
    WiFi transfer module was initializing WiFi at startup, which conflicted
    with wifi_ota module's WiFi initialization for scanning/updating.
    This caused "command timeout: wifi_scan" errors, effectively locking
    out OTA updates.
    Temporarily disabled wifi_transfer_init() to restore OTA capability.
    Future plan: Implement OTA relay via tablet hotspot instead of having
    ESP32 connect to external WiFi directly. Since we're already connecting
    to the tablet's LocalOnlyHotspot for CAN streaming, we can:
    1. Tablet downloads firmware from cloud over cellular/WiFi
    2. Tablet serves firmware to ESP32 over the existing hotspot connection
    3. No separate WiFi c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
    [wifi_transfer.c]
2026-11-02 Bump firmware to v1.2.2 with WiFi transfer improvements
    - Add local hotspot OTA support (wifi_ota_local command)
    - Improve WiFi/BLE coexistence handling
    - Send TCP ready confirmation on connection
    - Various bug fixes and improvements
    [can_manager.c, main.c, mcp2515.c, wifi_transfer.c]
2026-11-03 Make WiFi transfer async to fix BLE timeout (v1.2.3)
    WiFi transfer connect was blocking the BLE handler for 30+ seconds
    during connection attempts, causing command timeouts. Now spawns a
    background FreeRTOS task like wifi_ota does.
    [wifi_transfer.c]
2026-11-03 Add wifi_ota_local command for hotspot relay OTA (v1.2.4)
    Adds support for OTA updates via local hotspot relay:
    - New wifi_ota_local command that uses existing wifi_transfer connection
    - Downloads firmware from tablet HTTP server instead of cloud
    - Enables OTA when no external WiFi is available
2026-11-03 Bump firmware to v1.2.7 with local OTA fixes
    - Add explicit HTTP_TRANSPORT_OVER_TCP for local OTA (no TLS)
    - Improve error logging for OTA connection failures
    [wifi_ota.c]
2026-11-03 Bump firmware to v1.2.8 with detailed OTA error codes
    - Show specific error codes in OTA failure messages
    - Help diagnose HTTP connection issues
    [wifi_ota.c]
2026-11-03 Bump firmware to v1.2.10 - fix local OTA cert check
    - Add skip_cert_common_name_check for local HTTP OTA
    - Required by ESP-IDF even for plain HTTP connections
    [wifi_ota.c]
2026-11-03 Bump firmware to v1.2.13 - fix OTA cert check with use_global_ca_store
    - Add use_global_ca_store=true to bypass ESP-IDF certificate verification
    - skip_cert_common_name_check alone wasn't sufficient
    [wifi_ota.c]
